Samael312/ESPKI/Hardware/Documentación/Vistas/Vista Lateral Derecha Modelo 3D.png

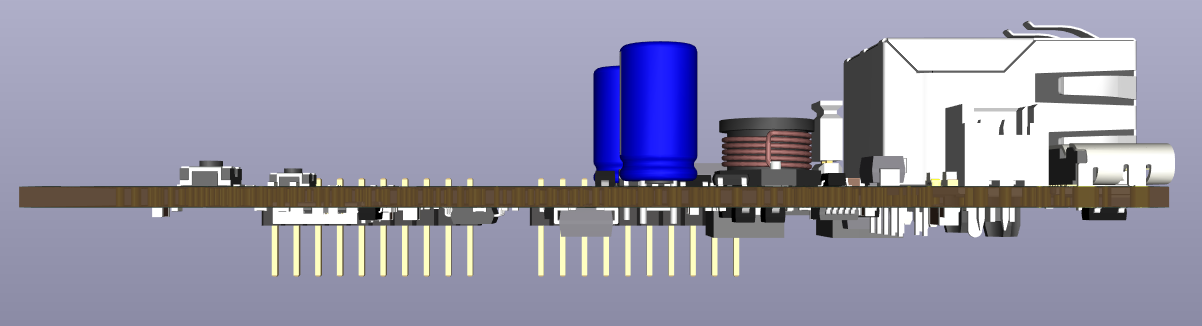
Hardware/Documentación/Vistas/Vista Lateral Derecha Modelo 3D.png
