Samael312/ESPKI/Hardware/Documentación/Vistas/Isometrica invertida.png

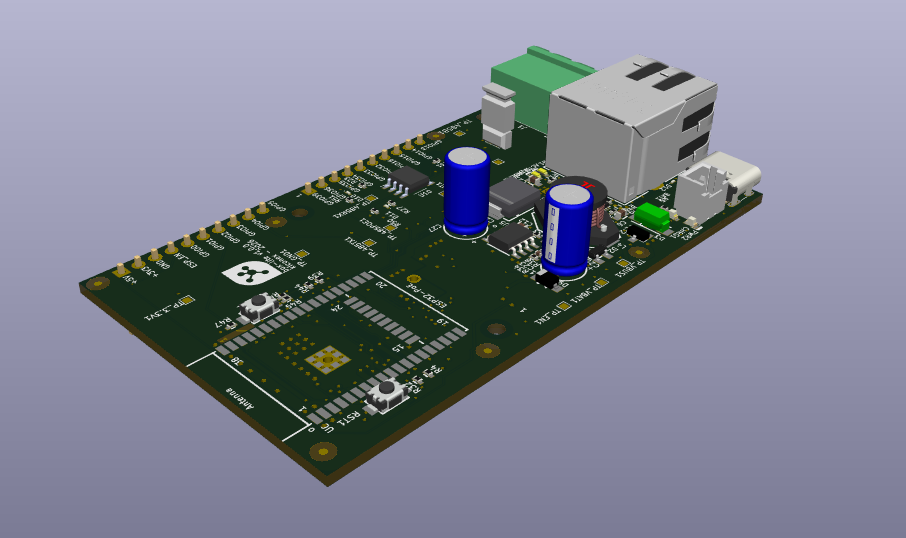
Hardware/Documentación/Vistas/Isometrica invertida.png
