Samael312/ESPKI/Hardware/Documentación/PERTE CHIP-kiconex box lite v1.00.docx

# Fase 1 — MPV y Prototipado

Objetivo: Evaluación de requisitos mínimos y selección de elementos para prototipado y pruebas básicas. Demostrar integración mínima con la arquitectura MQTT actual e inyectar métricas virtuales para cerrar la decisión de hardware.

### 1. Contrato de integración mínimo

Definir el contrato mínimo de intercambio con backend para permitir:

- presencia del dispositivo en plataforma
- publicación de telemetría básica
- señalización de estado de conexión
- y recepción básica de configuración

Debe quedar cerrado:

- estructura de topics
- formato JSON
- identificador único de dispositivo
- frecuencia de publicación
- QoS/retained cuando aplique
- Criterios de validación por mensaje

Al menos deberían existir estos mensajes:

- connection/status
- telemetry
- link-status (opcional en MVP)
- ack/error de configuración

Entregable:
Requerimientos Kiconex Box Lite – v0.0.1

Go/No-Go: documentación de implementación mínima

Recomendación: fijar ya valores por defecto para funcionamiento básico, por ejemplo:

1. telemetría cada 60 s
2. connection/status con LWT
3. payloads JSON estrictos con campos obligatorios definidos

### 2. Firmware base

Seleccionar la base técnica del MVP:

- MCU objetivo
- framework de desarrollo
- RTOS / arquitectura de tareas
- estrategia de logs y diagnóstico

Debe incluir:

- arranque robusto
- logs por UART
- contador de reinicios
- Watchdog
- separación mínima de tareas (net, mqtt, telemetry, supervision)

Entregable: firmware que arranca y permanece estable durante 24 h.

Go/No-Go: sin bloqueos, sin reinicios inesperados y con arranque reproducible.

Punto crítico: en esta fase conviene decidir también la estrategia de build:

- ESP-IDF si se prioriza control fino y estabilidad
- PlatformIO si priorizáis velocidad de iteración

3. Conexión al broker y publicación

Implementar el cliente MQTT con:

- conexión
- reconexión automática
- LWT online/offline
- publicación periódica
- y patrón de datos dummy determinista para depuración

Debe validarse en dos escenarios:

- sin TLS
- con TLS/certificados

Entregable: dispositivo visible en plataforma y datos visibles en una vista simple.

Go/No-Go:

- conexión estable con TLS
- reconexión automática funcional
- publicación continua sin intervención manual
- presencia correcta en vista simple/extendida

Recomendación: usar datos dummy reproducibles (contador, onda simple, secuencia fija) para que backend y firmware puedan depurar exactamente el mismo comportamiento.

### 4.1. Suscripción a topics de configuración

Añadir suscripción a:

- device
- controls
- controls-entities

Implementar:

- recepción
- parseo
- validación estructural

En esta fase el objetivo no es “usar toda la config”, sino comprobar que el dispositivo:

- la recibe
- la entiende
- y no colapsa en memoria

Entregable: dispositivo que recibe configuración correctamente o informe justificando límite de memoria.

Go/No-Go:

- tasa de parseo correcta
- validación consistente
- consumo de memoria dentro de umbrales aceptables

### 4.2. Medición para decisión de hardware

Realizar mediciones objetivas para cerrar el hardware:

- uso medio y pico de CPU
- uso medio y pico de RAM
- flash ocupada
- consumo eléctrico
- latencia de publish
- tiempo de reconexión
- comportamiento ante red degradada

Ensayos mínimos:

- caída de broker
- pérdida de red
- reconexión repetida
- arranque en condiciones no ideales
- test de estabilidad 24–72 h

Entregable: informe de dimensionamiento con recomendación de MCU y memoria

Go/No-Go: recomendación de hardware cerrada con evidencia medible

Umbrales sugeridos:

- RAM pico < 70%
- tiempo de reconexión < 15 s
- uptime de 72 h sin reset inesperado
- margen de flash suficiente para crecimiento futuro

### 5. Finalización de Fase 1

Con la evidencia de la fase, cerrar:

- decisión de hardware
- interfaces físicas mínimas
- y requisitos suficientes para iniciar PCB/mecánico en paralelo.

Entregable: Requerimiento Hardware Fase 1

Salida de fase: base suficientemente estable para iniciar diseño electrónico-industrial sin rehacer la arquitectura

## Criterio de éxito de Fase 1

La Fase 1 se considera superada si:

- el dispositivo aparece en plataforma como conectado
- publica telemetría cada 60 s durante 24–72 h
- soporta pérdida de red y se reconecta solo
- y queda validado el dimensionamiento de hardware para arrancar el diseño físico.

# Fase 2 — Prototipo con funcionamiento completo

Objetivo: cubrir operación real de campo con configuración remota, control, protocolo industrial y robustez de explotación.

### 1. Modelo de datos y configuración remota

Implementar el modelo completo:

- device
- controls
- entities

Con:

- límites explícitos,
- validación de configuración,
- persistencia en NVS/flash,
- ack/error de aplicación.

Aquí ya no basta con recibir la config: debe aplicarse y persistir tras reinicio.

### 2. Protocolo de campo

Prioridad inicial: Modbus

Implementar:

- polling,
- GET / REPORT / SET,
- timeouts,
- retries,
- estado online/offline del control,
- publicación de estados y valores compatibles con backend.

### 3. Store-and-forward

Definir política de resiliencia de datos:

- cola persistente en flash o cola en RAM
- límites máximos
- política de descarte
- TTL
- prioridad
- replay ordenado al reconectar.

### 4. Comandos operativos

Implementar como mínimo:

- provision
- halt/restart
- device-info

Además:

- diagnóstico remoto,
- métricas de salud,
- y visibilidad de estado interno.

### 5. Seguridad y endurecimiento

- Añadir:
- TLS/certificados,
- límites anti-flood,
- watchdog integral,
- brown-out handling,
- tests prolongados,
- y validación ante reconexiones masivas.
- Ensayos recomendados:
- soak test de 72 h+
- ciclos de reconexión repetidos
- microcortes de alimentación
- degradación de señal/red

### 6. Piloto real

- Desplegar un piloto controlado:
- 2 a 5 equipos
- entorno real
- comparativa funcional frente a quiiotd
- identificación de gaps
- cierre de backlog previo a preproducción

## Criterio de éxito de Fase 2

- La Fase 2 se considera superada si:
- la integración es completa en el backend actual, sin flujos especiales,
- el control remoto y la adquisición de campo son estables,
- el equipo resiste cortes de red y energía,
- y la base queda lista para iterar hacia producto.
