Samael312/ESPKI/Hardware/Documentación/Carcasa/Vistas/Base.png

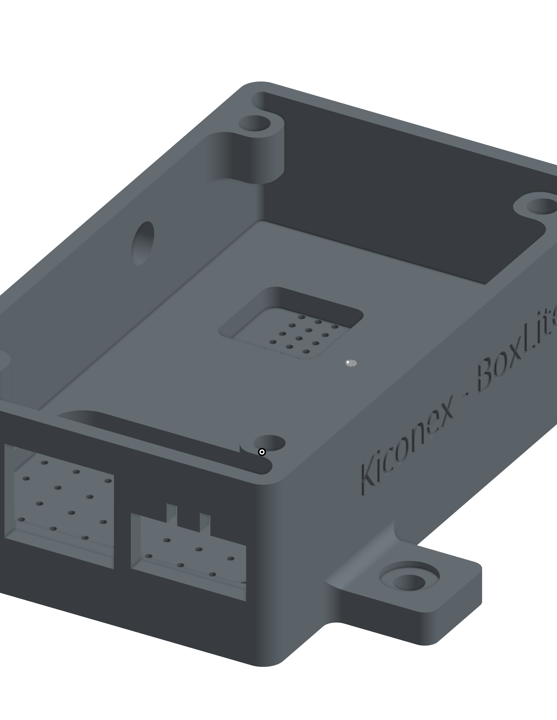
Hardware/Documentación/Carcasa/Vistas/Base.png
