Samael312/ESPKI/Hardware/Documentación/Carcasa/Vistas/Cubierta.png

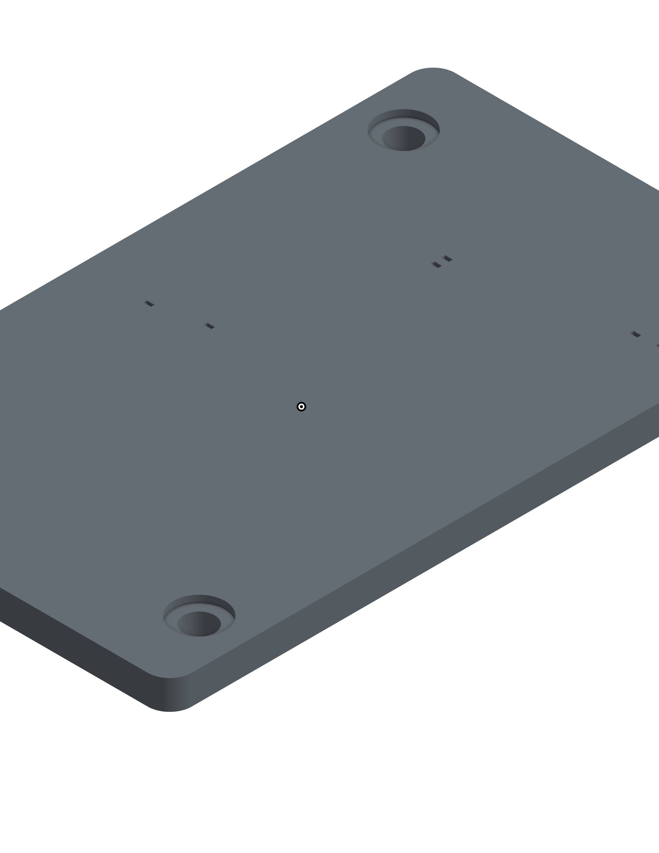
Hardware/Documentación/Carcasa/Vistas/Cubierta.png
