Samael312/ESPKI/Hardware/Documentación/Vistas/Vista Frontal Modelo 3D.png

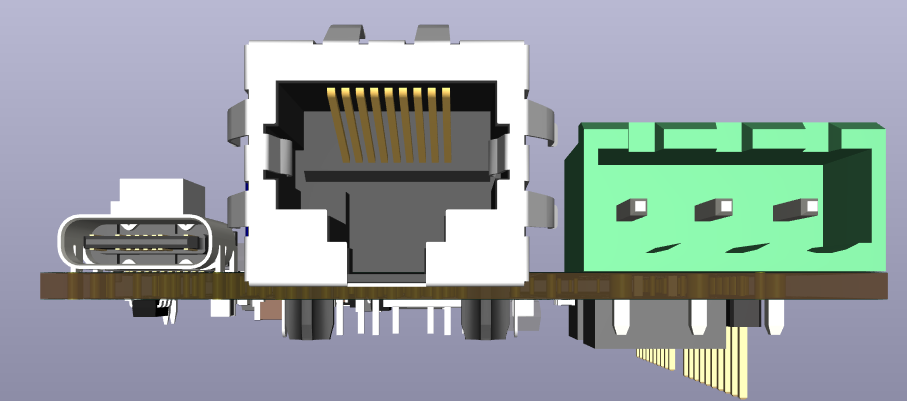
Hardware/Documentación/Vistas/Vista Frontal Modelo 3D.png
