Samael312/ESPKI/Hardware/Documentación/Vistas/Vista Lateral Izquierda Modelo 3D.png

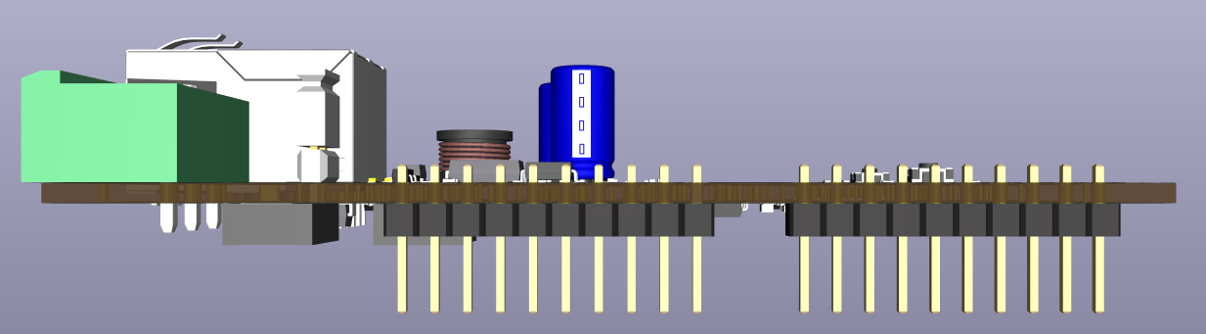
Hardware/Documentación/Vistas/Vista Lateral Izquierda Modelo 3D.png
