Samael312/ESPKI/Hardware/Documentación/Vistas/Vista Trasera Modelo 3D.png

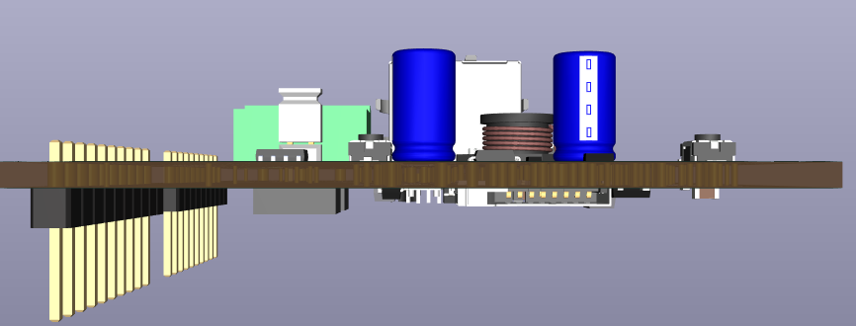
Hardware/Documentación/Vistas/Vista Trasera Modelo 3D.png
