Samael312/ESPKI/Hardware/Carcasa.FCStd

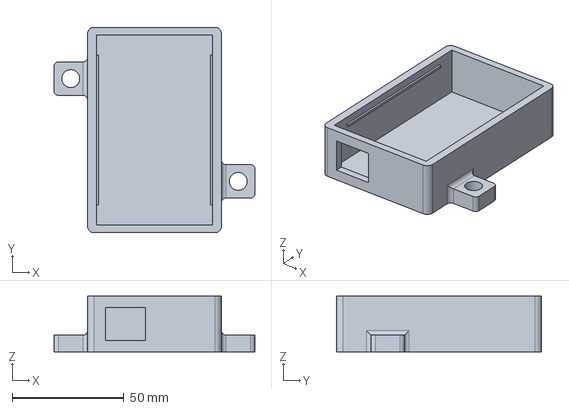
[picture p15: CAD file, 2026-04-23]
Hardware/Carcasa.FCStd
90.0 x 92.0 x 25.0 mm
