Samael312/ESPKI/Hardware/Documentación/Carcasa/Base.step

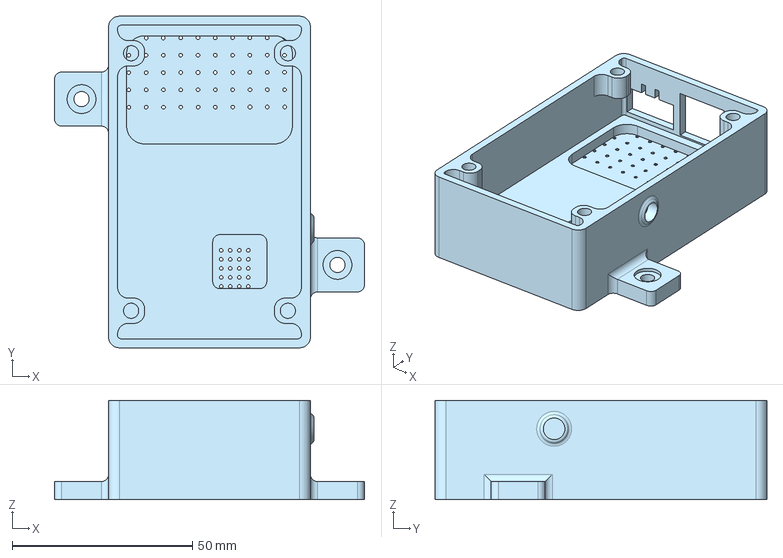
[picture p16: CAD file, 2026-04-24]
Hardware/Documentación/Carcasa/Base.step
86.0 x 92.0 x 27.5 mm
