Samael312/ESPKI/Hardware/Box-Lite.FCStd

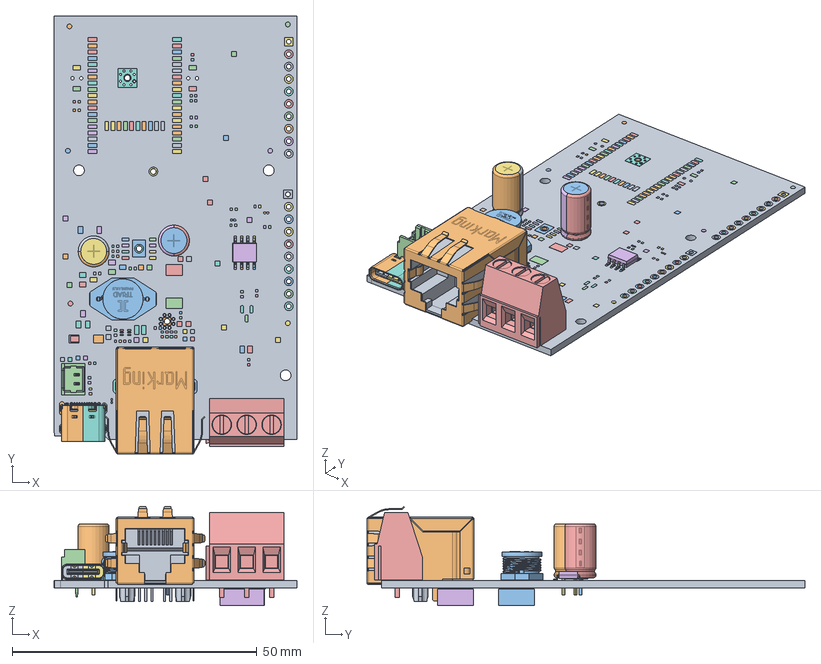
[picture p17: CAD file, 2026-04-23]
Hardware/Box-Lite.FCStd
49.6 x 89.4 x 20.2 mm
insulator
shielding
Cap_PTH_6_3x11x2_5mm
Cap_PTH_6_3x11x2_5mm001
Cap_PTH_6_3x11x2_5mm002
Cap_PTH_6_3x11x2_5mm003
Cap_PTH_6_3x11x2_5mm005
Cap_PTH_6_3x11x2_5mm006
Cap_PTH_6_3x11x2_5mm007
Cap_PTH_6_3x11x2_5mm008
L_AX97-103R3
Molex_PicoBlade_530470210
TerminalBlock_Phoenix_MKDS-1,5-3-5.08_1x03_P5.08mm_Horizontal
MAX13487E
MAX13487E001
MAX13487E002
MAX13487E003
MAX13487E004
MAX13487E005
MAX13487E006
MAX13487E007
MAX13487E008
USB_C_Receptacle_GCT_USB4105-xx-A_16P_TopMnt_Horizontal
USB_C_Receptacle_GCT_USB4105-xx-A_16P_TopMnt_Horizontal001
USB_C_Receptacle_GCT_USB4105-xx-A_16P_TopMnt_Horizontal002
USB_C_Receptacle_GCT_USB4105-xx-A_16P_TopMnt_Horizontal003
USB_C_Receptacle_GCT_USB4105-xx-A_16P_TopMnt_Horizontal004
USB_C_Receptacle_GCT_USB4105-xx-A_16P_TopMnt_Horizontal005
USB_C_Receptacle_GCT_USB4105-xx-A_16P_TopMnt_Horizontal006
USB_C_Receptacle_GCT_USB4105-xx-A_16P_TopMnt_Horizontal007
USB_C_Receptacle_GCT_USB4105-xx-A_16P_TopMnt_Horizontal008
USB_C_Receptacle_GCT_USB4105-xx-A_16P_TopMnt_Horizontal009
USB_C_Receptacle_GCT_USB4105-xx-A_16P_TopMnt_Horizontal010
USB_C_Receptacle_GCT_USB4105-xx-A_16P_TopMnt_Horizontal011
USB_C_Receptacle_GCT_USB4105-xx-A_16P_TopMnt_Horizontal012
USB_C_Receptacle_GCT_USB4105-xx-A_16P_TopMnt_Horizontal013
USB_C_Receptacle_GCT_USB4105-xx-A_16P_TopMnt_Horizontal014
USB_C_Receptacle_GCT_USB4105-xx-A_16P_TopMnt_Horizontal015
USB_C_Receptacle_GCT_USB4105-xx-A_16P_TopMnt_Horizontal016
USB_C_Receptacle_GCT_USB4105-xx-A_16P_TopMnt_Horizontal017
USB_C_Receptacle_GCT_USB4105-xx-A_16P_TopMnt_Horizontal018
USB_C_Receptacle_GCT_USB4105-xx-A_16P_TopMnt_Horizontal019
USB_C_Receptacle_GCT_USB4105-xx-A_16P_TopMnt_Horizontal020
USB_C_Receptacle_GCT_USB4105-xx-A_16P_TopMnt_Horizontal021
USB_C_Receptacle_GCT_USB4105-xx-A_16P_TopMnt_Horizontal022
USB_C_Receptacle_GCT_USB4105-xx-A_16P_TopMnt_Horizontal023
USB_C_Receptacle_GCT_USB4105-xx-A_16P_TopMnt_Horizontal024
USB_C_Receptacle_GCT_USB4105-xx-A_16P_TopMnt_Horizontal025
USB_C_Receptacle_GCT_USB4105-xx-A_16P_TopMnt_Horizontal026
USB_C_Receptacle_GCT_USB4105-xx-A_16P_TopMnt_Horizontal027
USB_C_Receptacle_GCT_USB4105-xx-A_16P_TopMnt_Horizontal028
USB_C_Receptacle_GCT_USB4105-xx-A_16P_TopMnt_Horizontal029
USB_C_Receptacle_GCT_USB4105-xx-A_16P_TopMnt_Horizontal030
USB_C_Receptacle_GCT_USB4105-xx-A_16P_TopMnt_Horizontal031
USB_C_Receptacle_GCT_USB4105-xx-A_16P_TopMnt_Horizontal032
USB_C_Receptacle_GCT_USB4105-xx-A_16P_TopMnt_Horizontal033
USB_C_Receptacle_GCT_USB4105-xx-A_16P_TopMnt_Horizontal034
USB_C_Receptacle_GCT_USB4105-xx-A_16P_TopMnt_Horizontal035
Pins
Pins001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
