Samael312/ESPKI/Hardware/Documentación/Carcasa/Cubierta.step

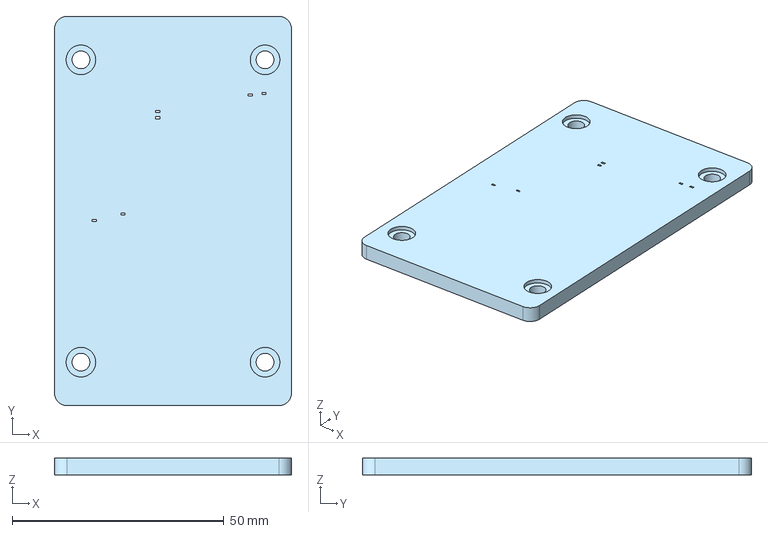
[picture p18: CAD file, 2026-04-24]
Hardware/Documentación/Carcasa/Cubierta.step
56.0 x 92.0 x 4.00 mm
