Samael312/ESPKI/Hardware/Documentación/Carcasa/Vistas/Ensamblaje.png

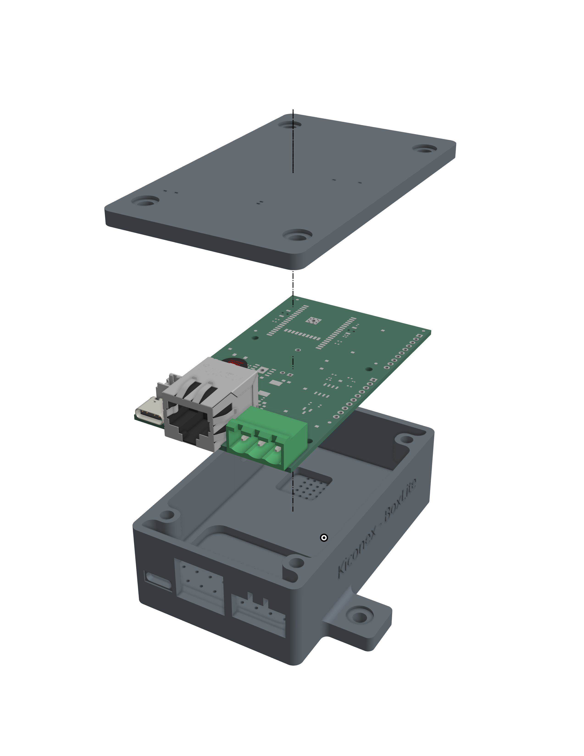
Hardware/Documentación/Carcasa/Vistas/Ensamblaje.png
