Samael312/ESPKI/Hardware/Documentación/Carcasa/Vistas/Ensamblaje_2.png

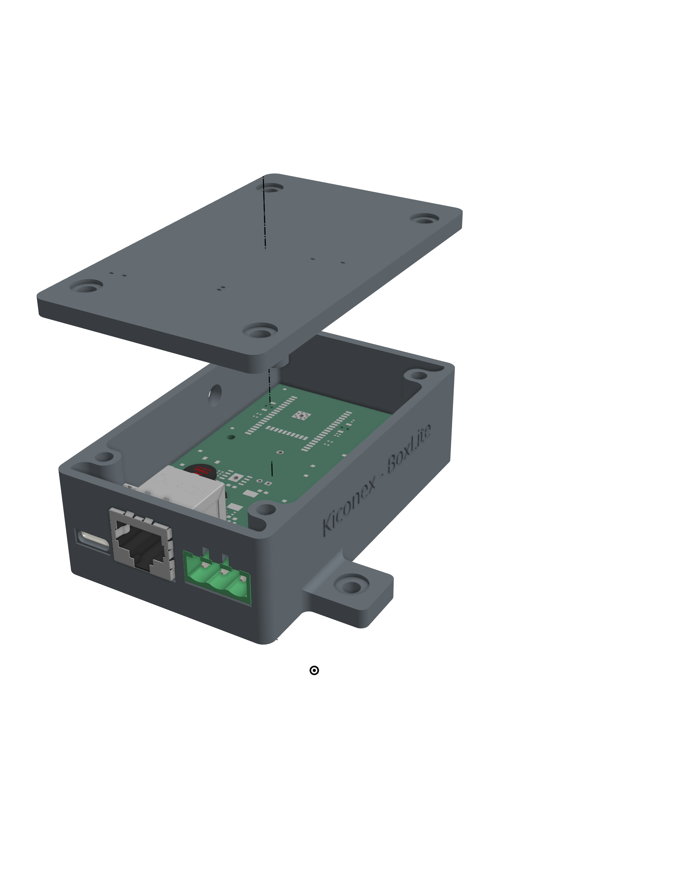
Hardware/Documentación/Carcasa/Vistas/Ensamblaje_2.png
