Samael312/ESPKI/Hardware/Documentación/KiBoxLite_H.pdf

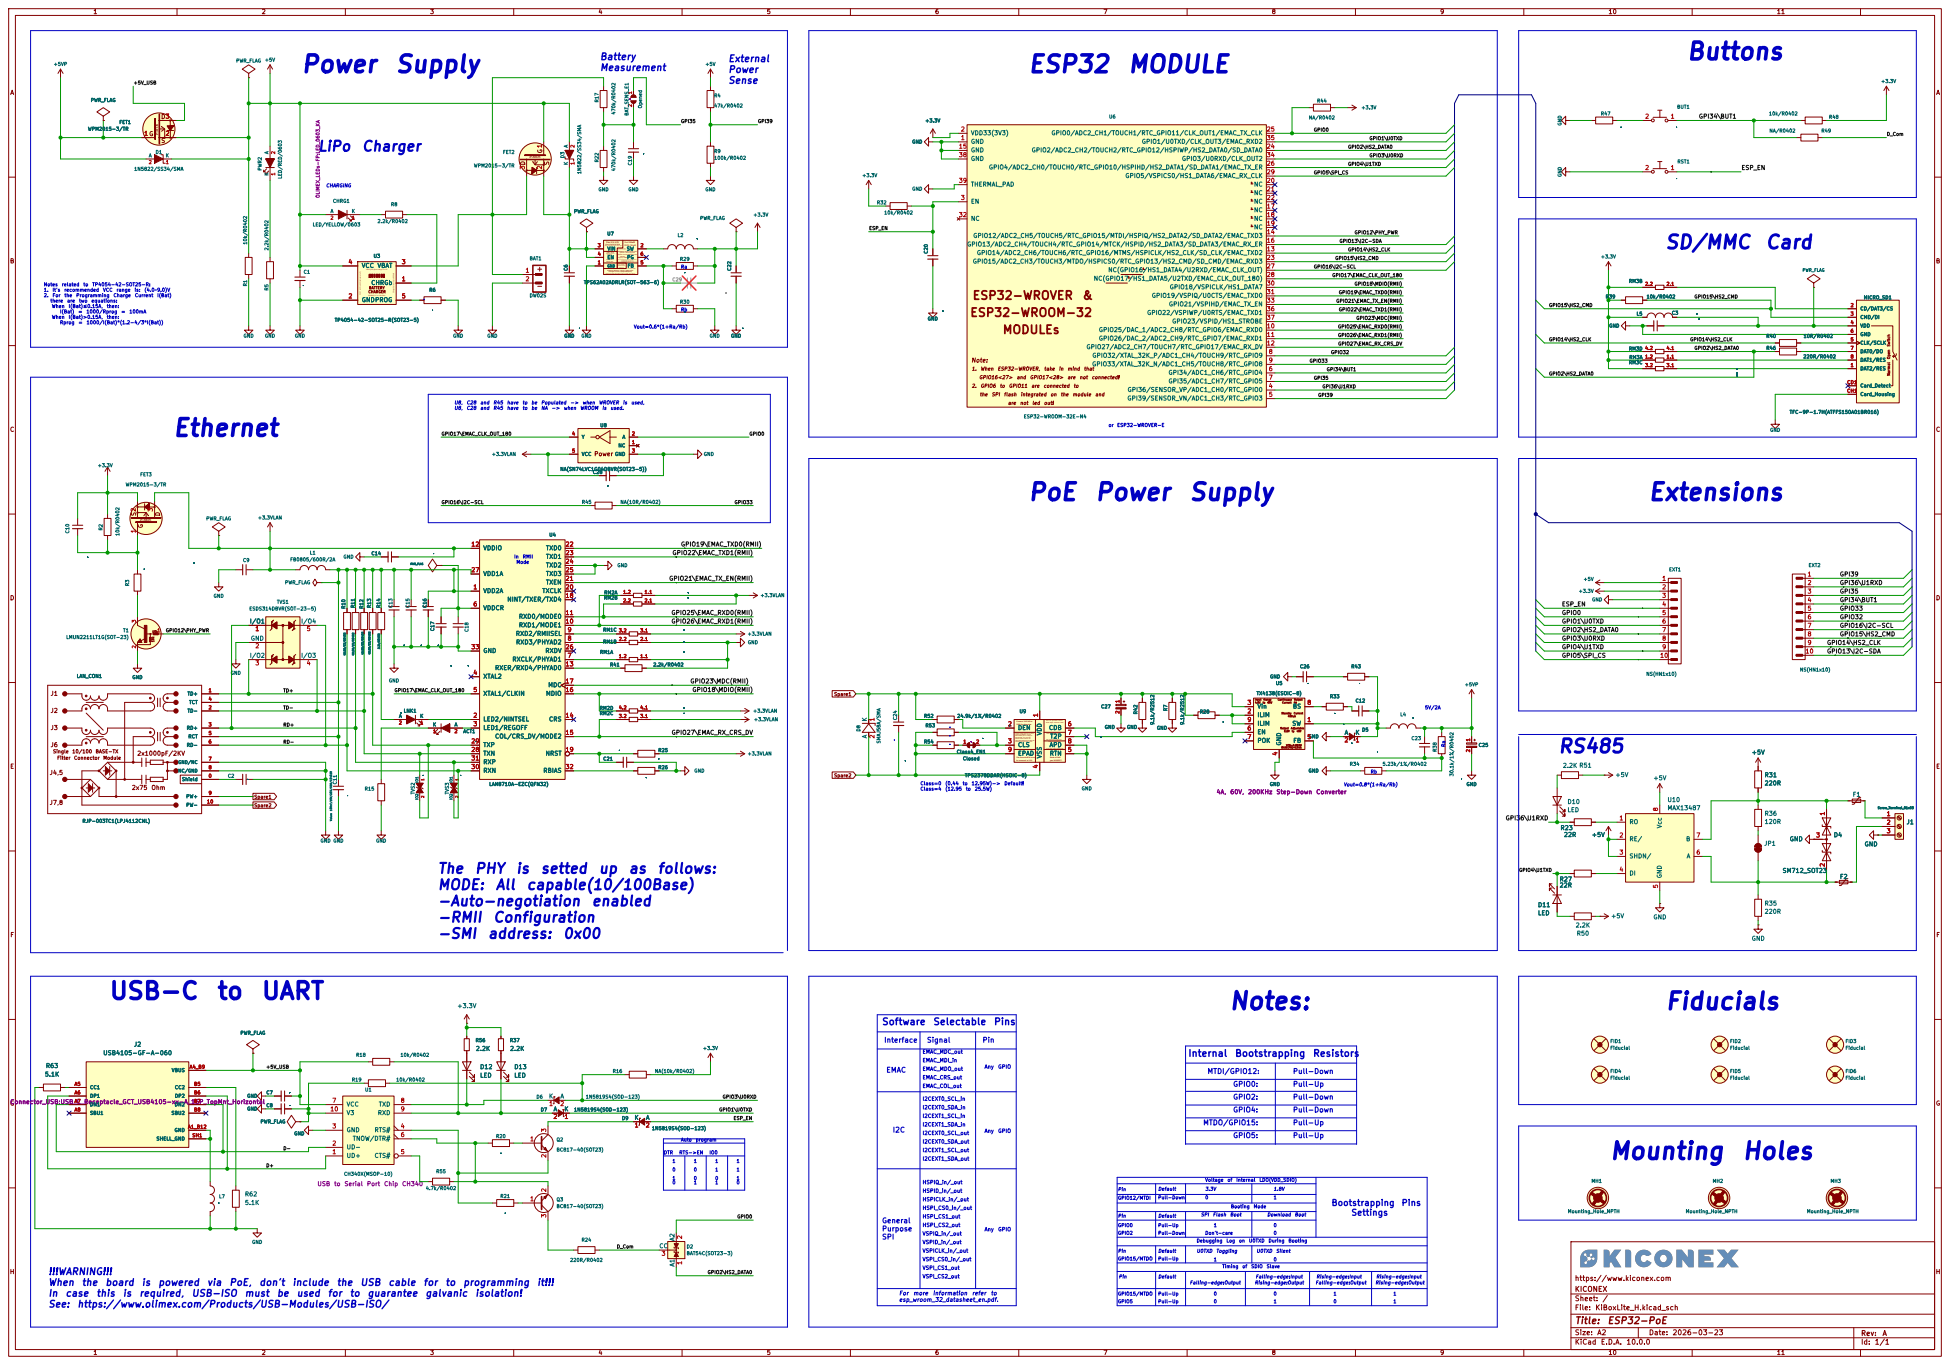
[picture p21: page 1]

LiPo Charger CHARGING A2CHRG1

SD/MMC Card +3.3V

Cin=4.7uF/6.3V/X5R
a larger value reduces input voltage ripple. Feedback Reference Voltage, V(REF)=0.6V

Pull high to turn on. Enable control. Vin=2.5-5.5V
VIN 3
TPS62A02ADRLR(SOT-563-6) GND 1

In case a lower output ripple is desired, higher output capacitance can help reduce the ripple. Lx=1.0uH

Do not float. V(ENH)=1.2V

A 0.47uH inductor can also be used with the same recommended output capacitors for the TPS62A02x. Switching Frequency 2.4MHz Maximum output current 2.0A

Cout=(10~22)uF/6.3V/X5R (Vout≥1.8V). 22uF Recommended! Cout=22uF/6.3V/X5R (1.2V≤Vout<1.8V) Cout=44uF/6.3V/X5R (0.6V≤Vout<1.2V)

FB Input Current, I(FB)=100nA(max) Rb must not be higher than 100kΩ to provide acceptable noise sensitivity. TPS62A02ADRLR

Notes related to TP4054-42-SOT25-R: 1. It's recommended VCC range is: (4.0~9.0)V 2. For the Programming Charge Current I(Bat)

1C24 A2 D8 SMAJ58A/SMA R25 10k/R0402 3.2 3.1 RM2C RA1206_(4X0603)_4B8_2.2k RM2D 4.2 4.1 RA1206_(4X0603)_4B8_2.2k C21 NA(10uF/6.3V/20%/X5R/C0603) RM1C 3.2 3.1 RA1206_(4X0603)_4B8_2.2k 1.2 1.1 RM1A RA1206_(4X0603)_4B8_2.2k Note: 2. GPIO6 to GPIO11 are connected to 1. When ESP32-WROVER, take in mind that are not led out! ESP32-WROVER &

there are two equations: When I(Bat)≤0.15A, then:

I(Bat) = 1000/Rprog = 100mA When I(Bat)>0.15A, then: Rprog = 1000/I(Bat)*(1.2-4/3*I(Bat))

Vout=0.6*(1+Ra/Rb) Rb

1 2 C25 Normal Open Switch DAT2/RES

the SPI flash integrated on the module and GPIO16<27> and GPIO17<28> are not connected!

GPIO25\EMAC_RXD0(RMII) GPIO22\EMAC_TXD1(RMII) GPIO22\EMAC_TXD1(RMII) GPIO21\EMAC_TX_EN(RMII)

1GND | 5 I/O3

TX4138(ESOIC-8) 4A, 60V, 200KHz Step-Down Converter GND

TX4138(ESOIC-8) 4A, 60V, 200KHz Step-Down Converter SW

IBIAS(FB)=10nA Standby Current 400uA Output Adjustable 0.8V to 40V

Filter Connector Module Single 10/100 BASE-TX J4,5

Class=0 (0.44 to 12.95W)-> Default! Class=4 (12.95 to 25.5W)

I2CEXT1_SDA_in The PHY is setted up as follows:
MODE: All capable(10/100Base)
-Auto-negotiation enabled
-RMII Configuration
-SMI address: 0x00

EMAC_CRS_out EMAC_MDC_out | Any GPIO Software Selectable Pins

Pull-Up

U1 CH340X(MSOP-10) USB to Serial Port Chip CH340
VCC 7

Falling-edge:Output Pull-Down Pull-Down Default GPIO12/MTDI GPIO2 GPIO0 PinPin VSPI_CS1_out

Default Pull-Up

Settings

Falling-edge:Input | Falling-edge:Output | 1 GPIO15/MTDO Rising-edge:Output

0 !!!WARNING!!!
When the board is powered via PoE, don't include the USB cable for to programming it!!!
In case this is required, USB-ISO must be used for to guarantee galvanic isolation!
See: https://www.olimex.com/Products/USB-Modules/USB-ISO/

Timing of SDIO Slave

GPIO15/MTDO | 0 0 | | | 1

Size: A2 | Rev: A
