Samael312/ESPKI/Hardware/Documentación/Carcasa/Chasis.pdf

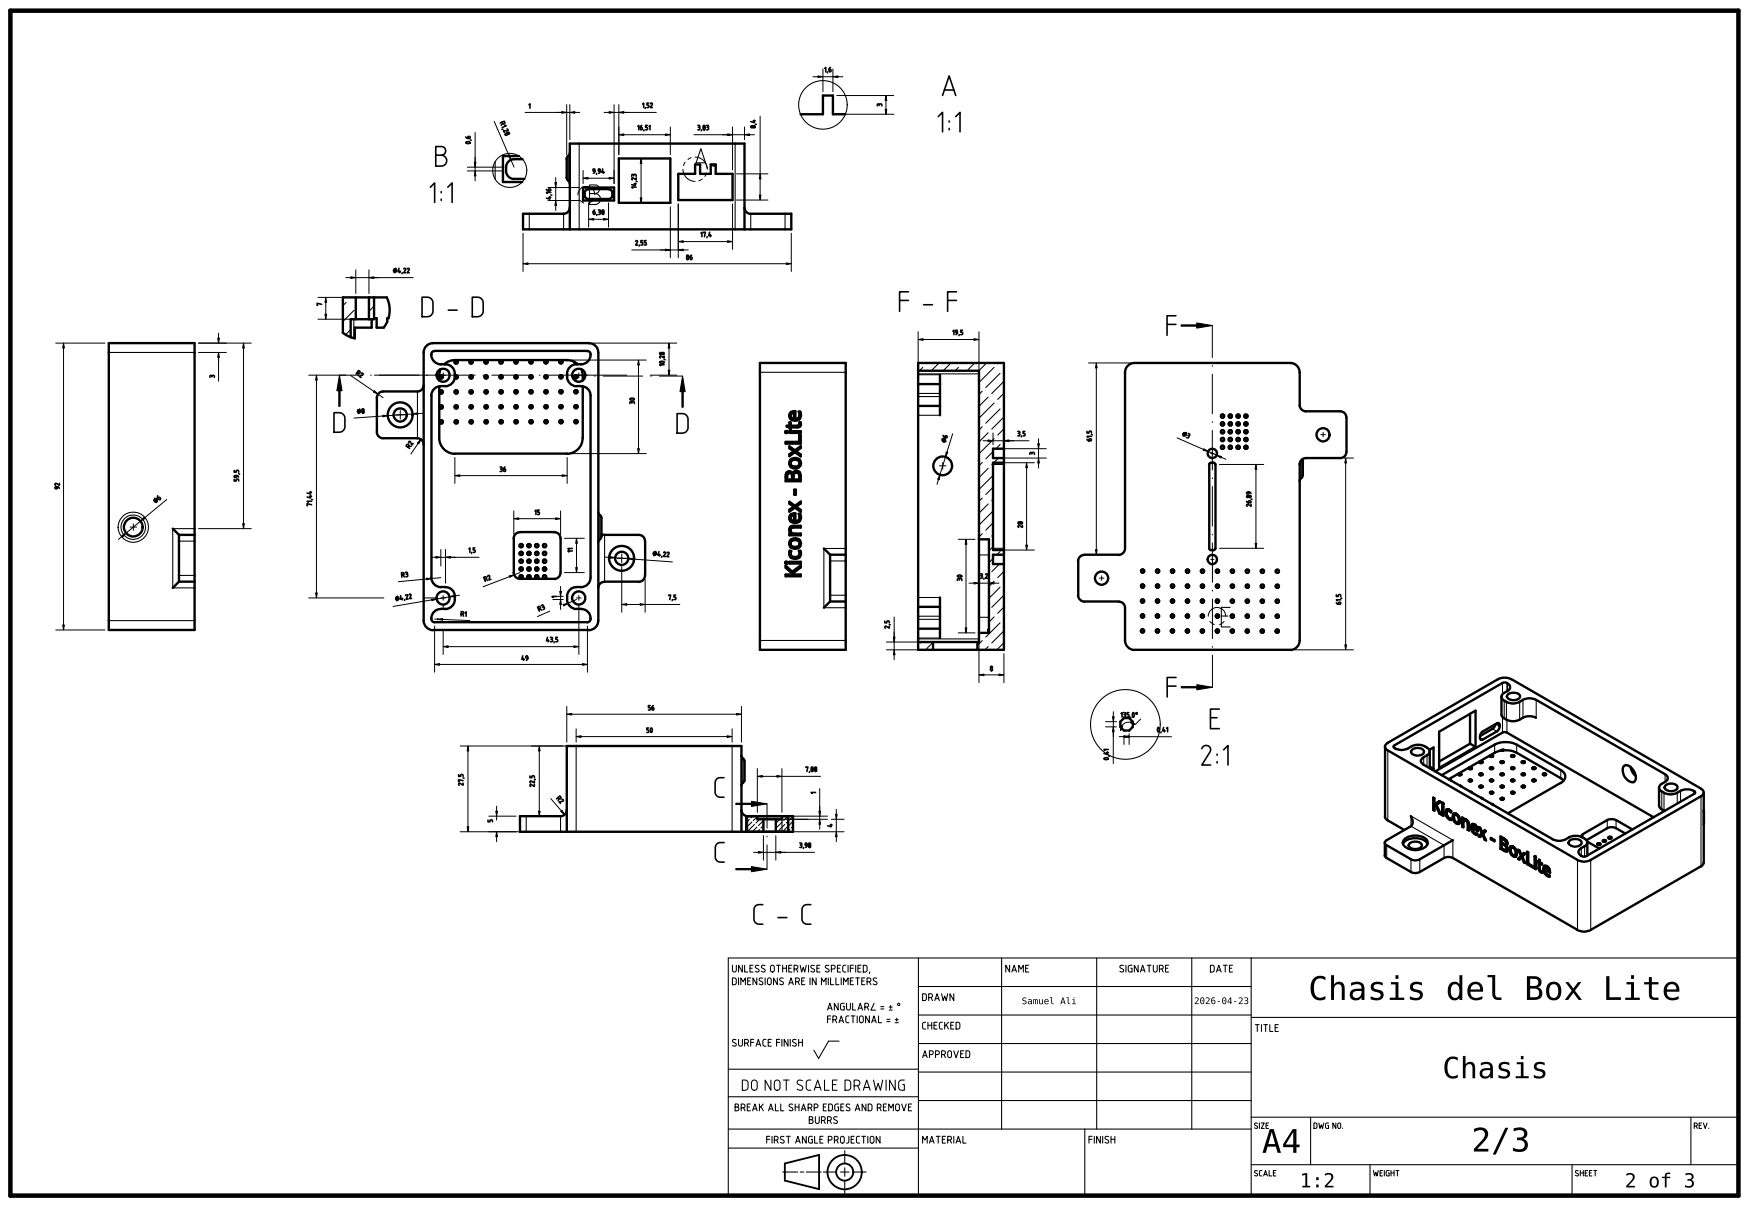
[picture p22: page 1]
