Samael312/ESPKI/Hardware/Documentación/Carcasa/Cubierta.pdf

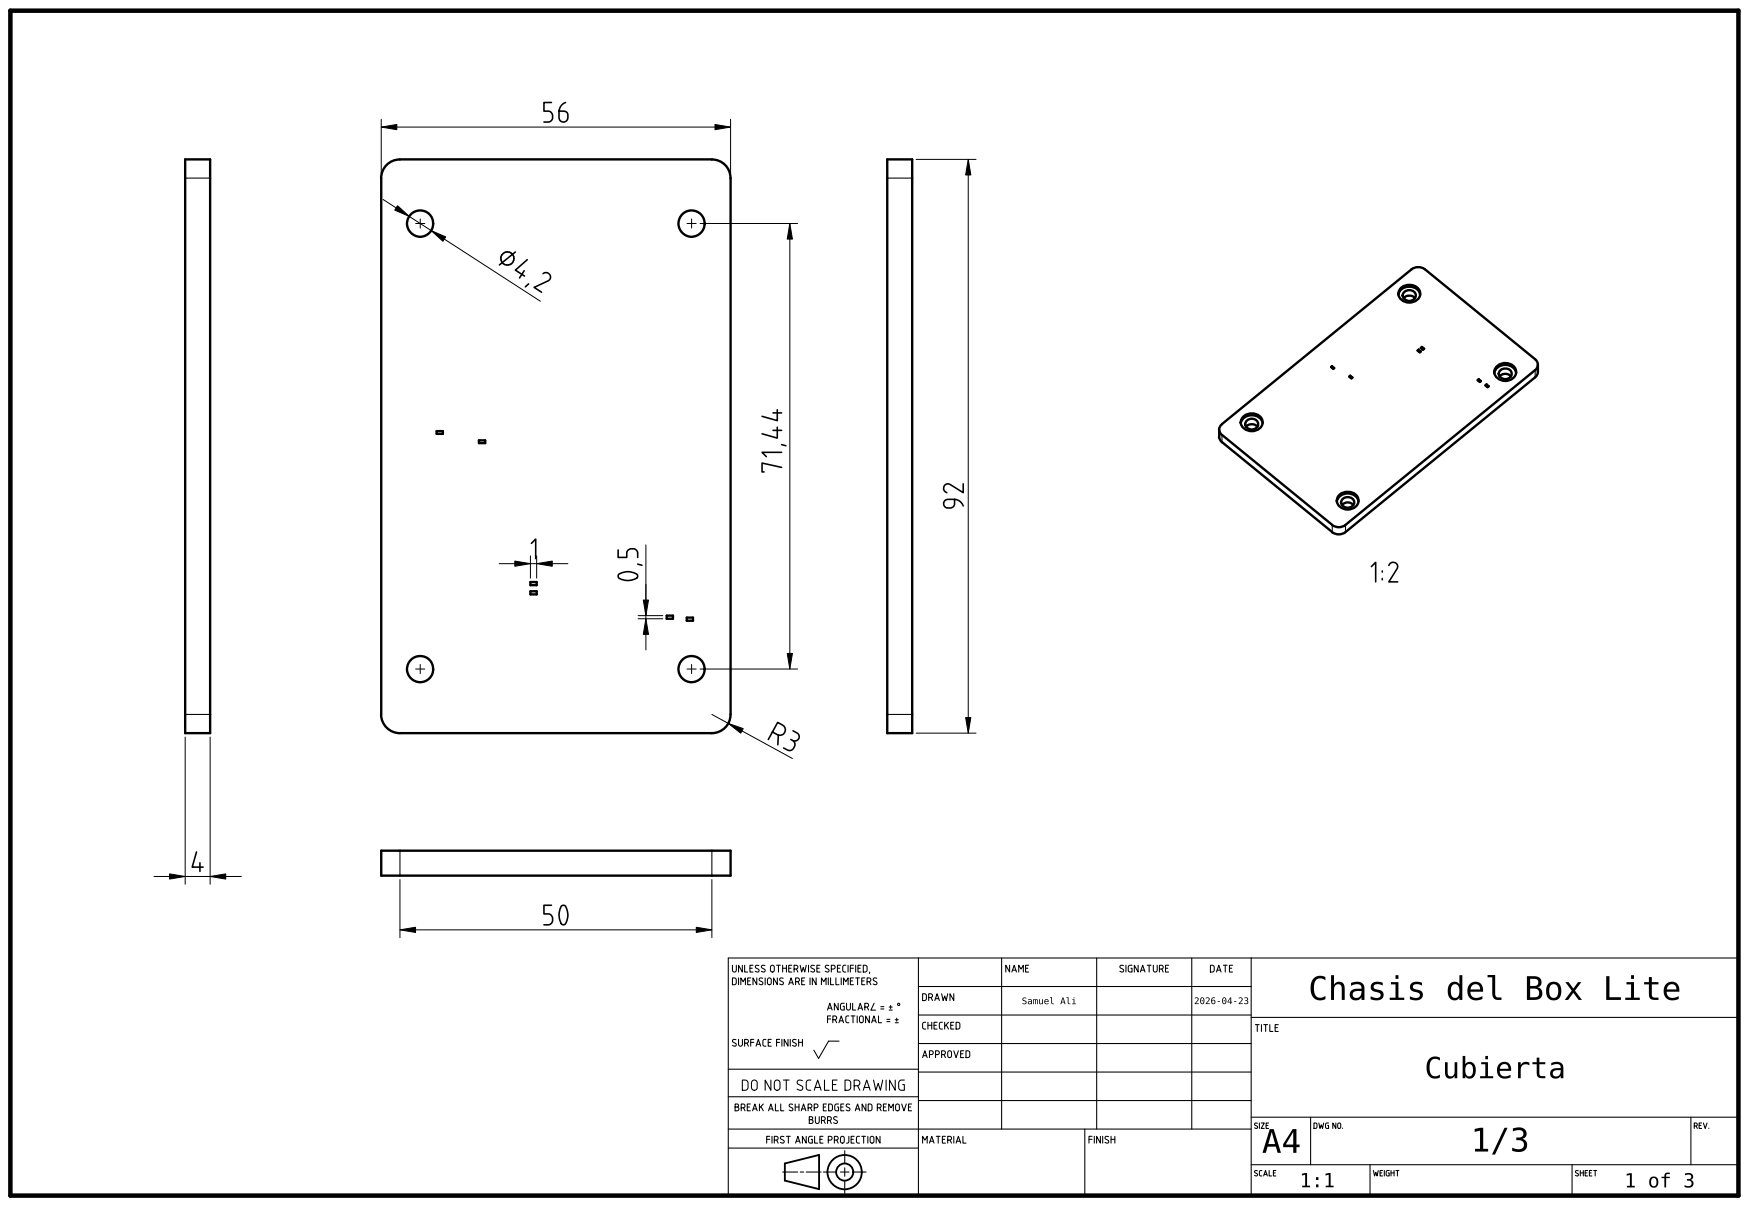
[picture p23: page 1]
