Samael312/ESPKI/Hardware/Documentación/Carcasa/Ensamblaje.pdf

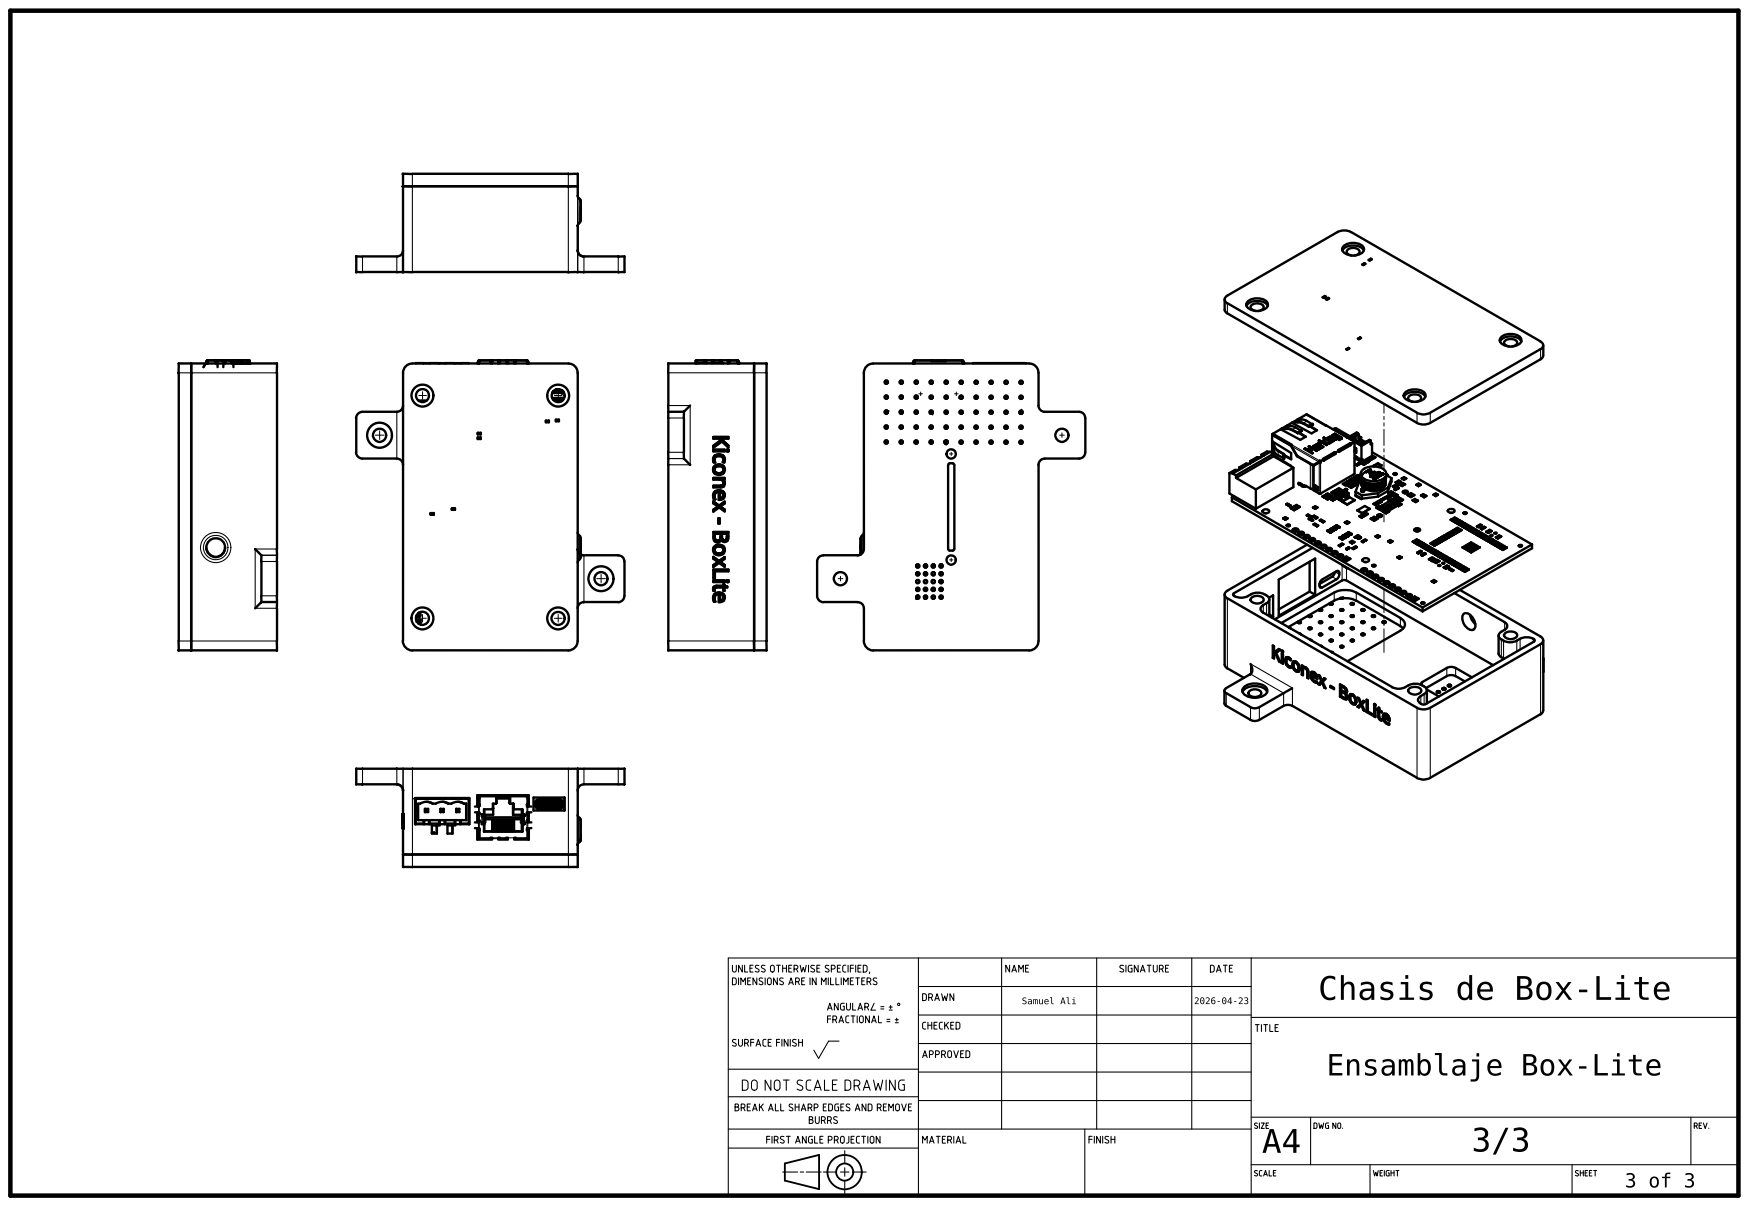
[picture p24: page 1]
