Samael312/ESPKI/Hardware/KiBoxLite_H.kicad_pcb

## KiCad design Hardware/KiBoxLite_H.kicad_pcb (2026-05-05)

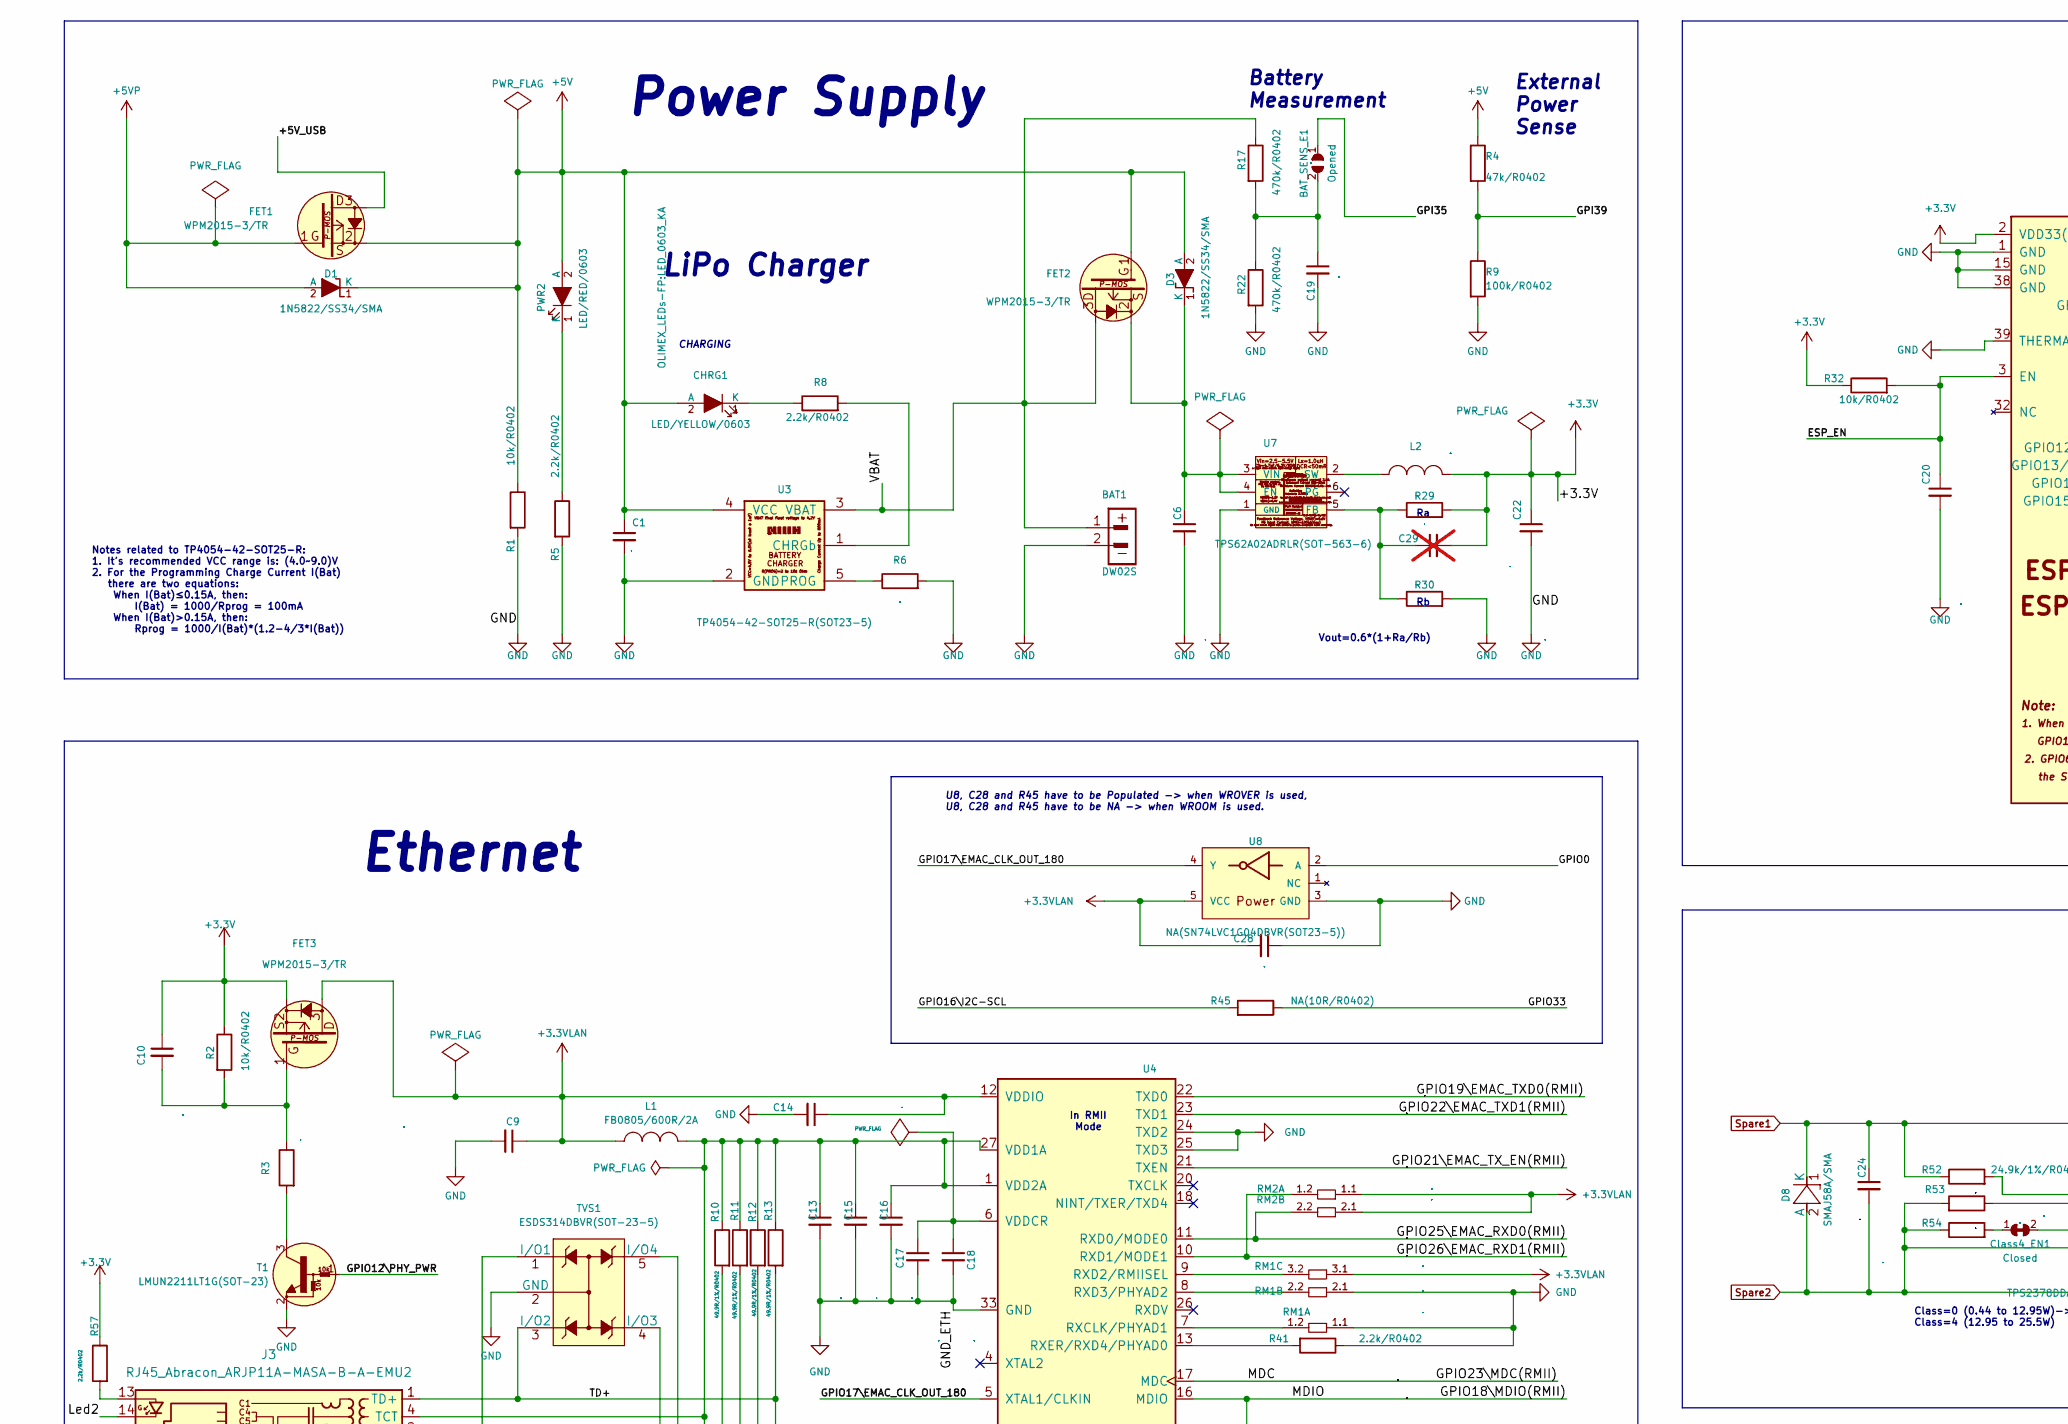
[picture p25: schematic KiBoxLite_H.kicad_sch, ESP32-PoE, part in row 1, column 1]

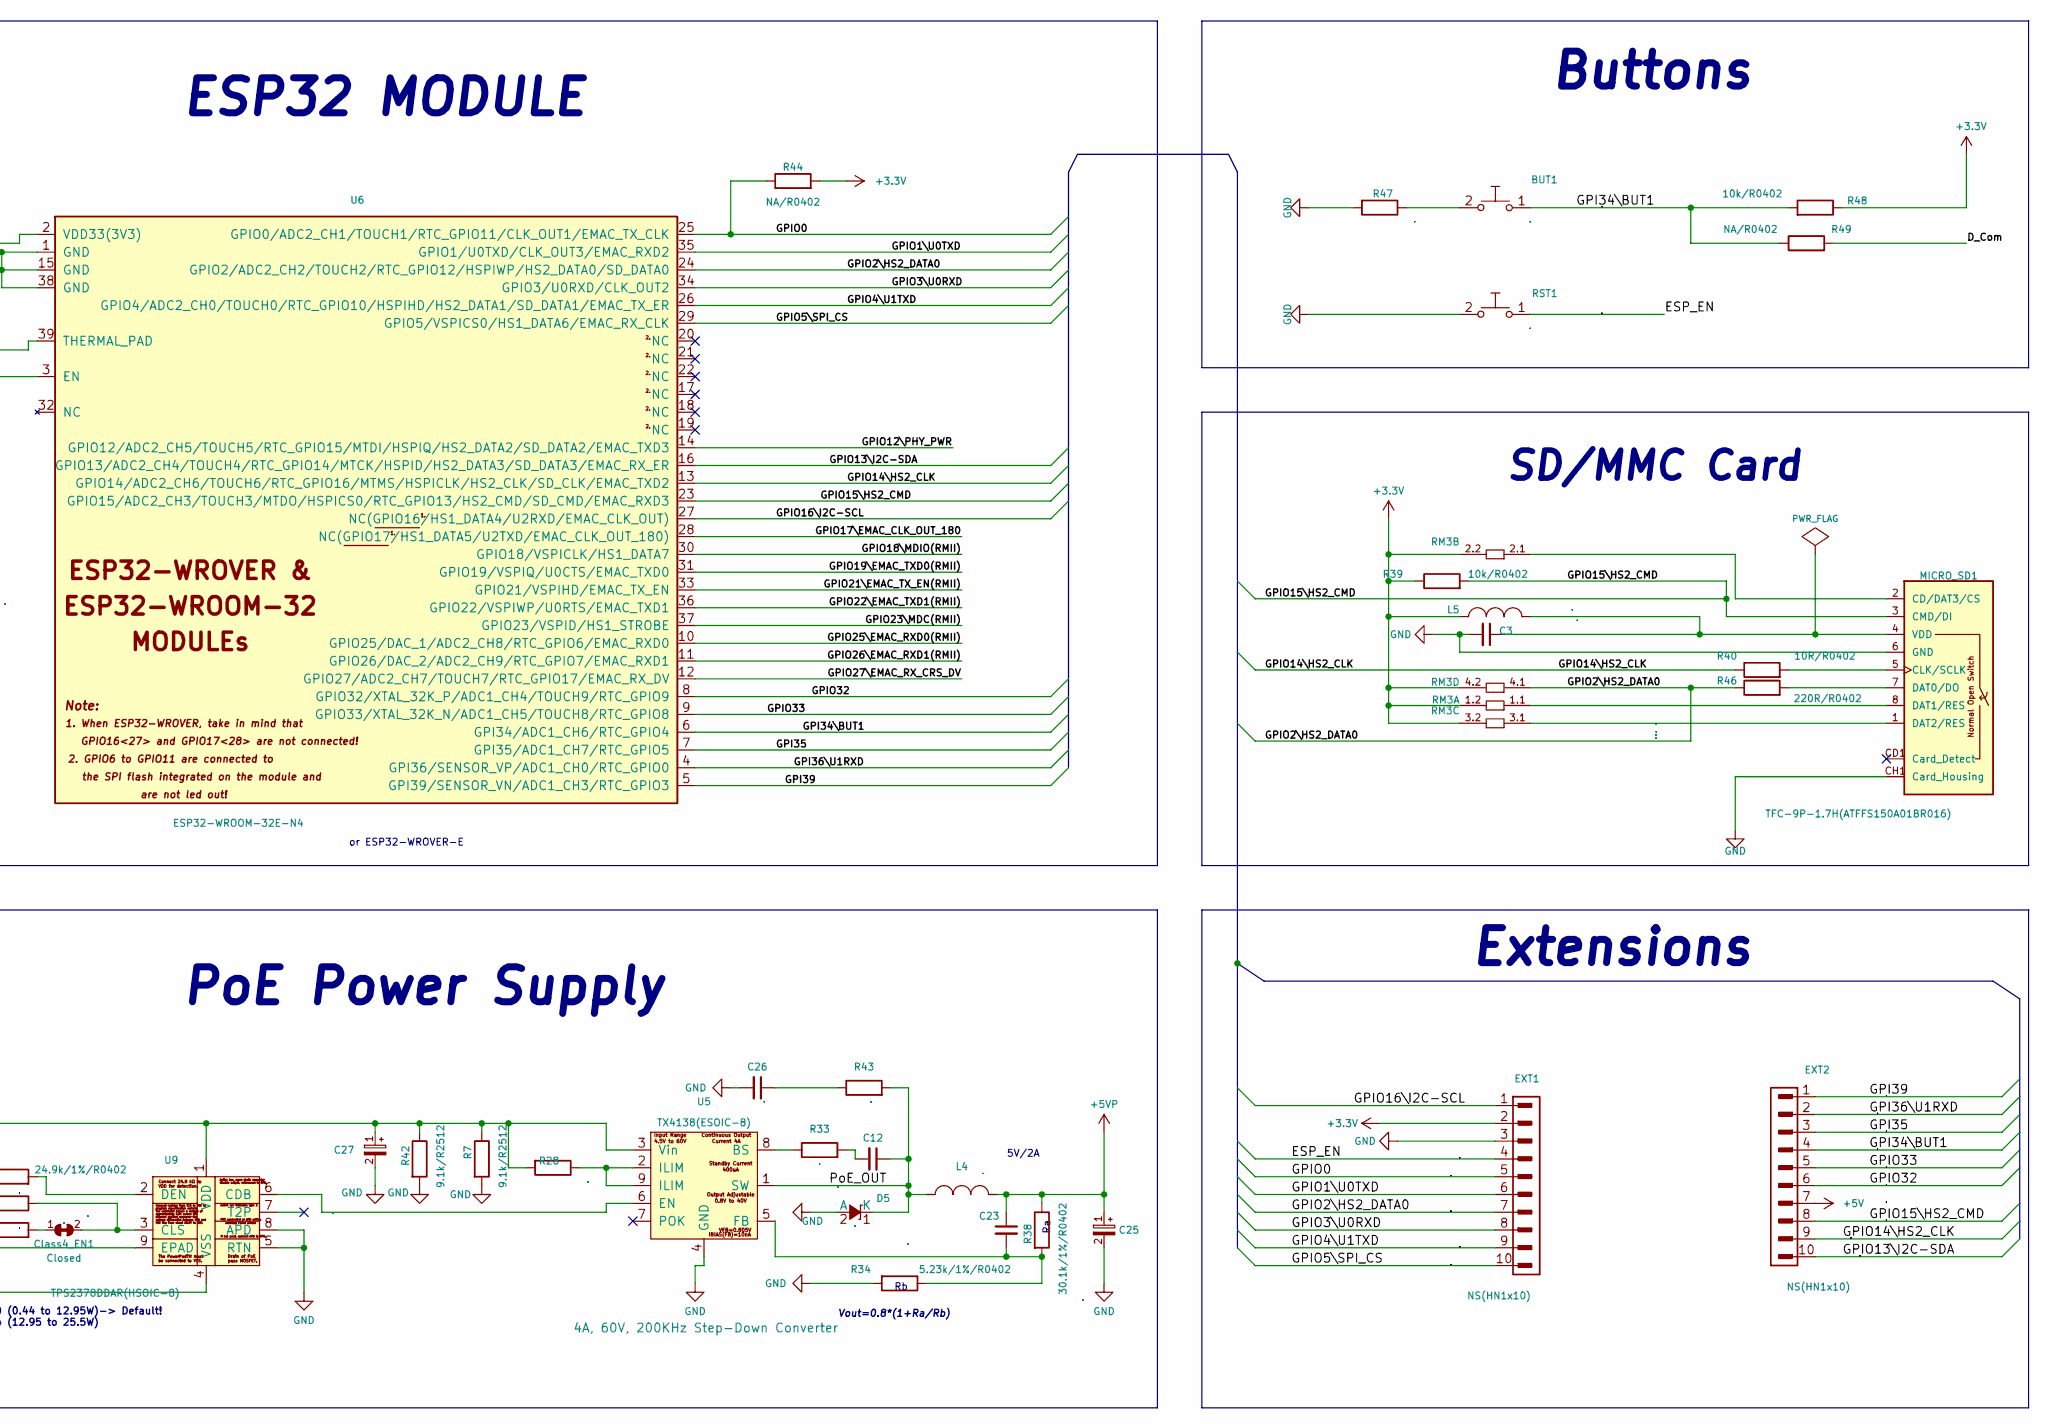
[picture p26: schematic KiBoxLite_H.kicad_sch, ESP32-PoE, part in row 1, column 2]

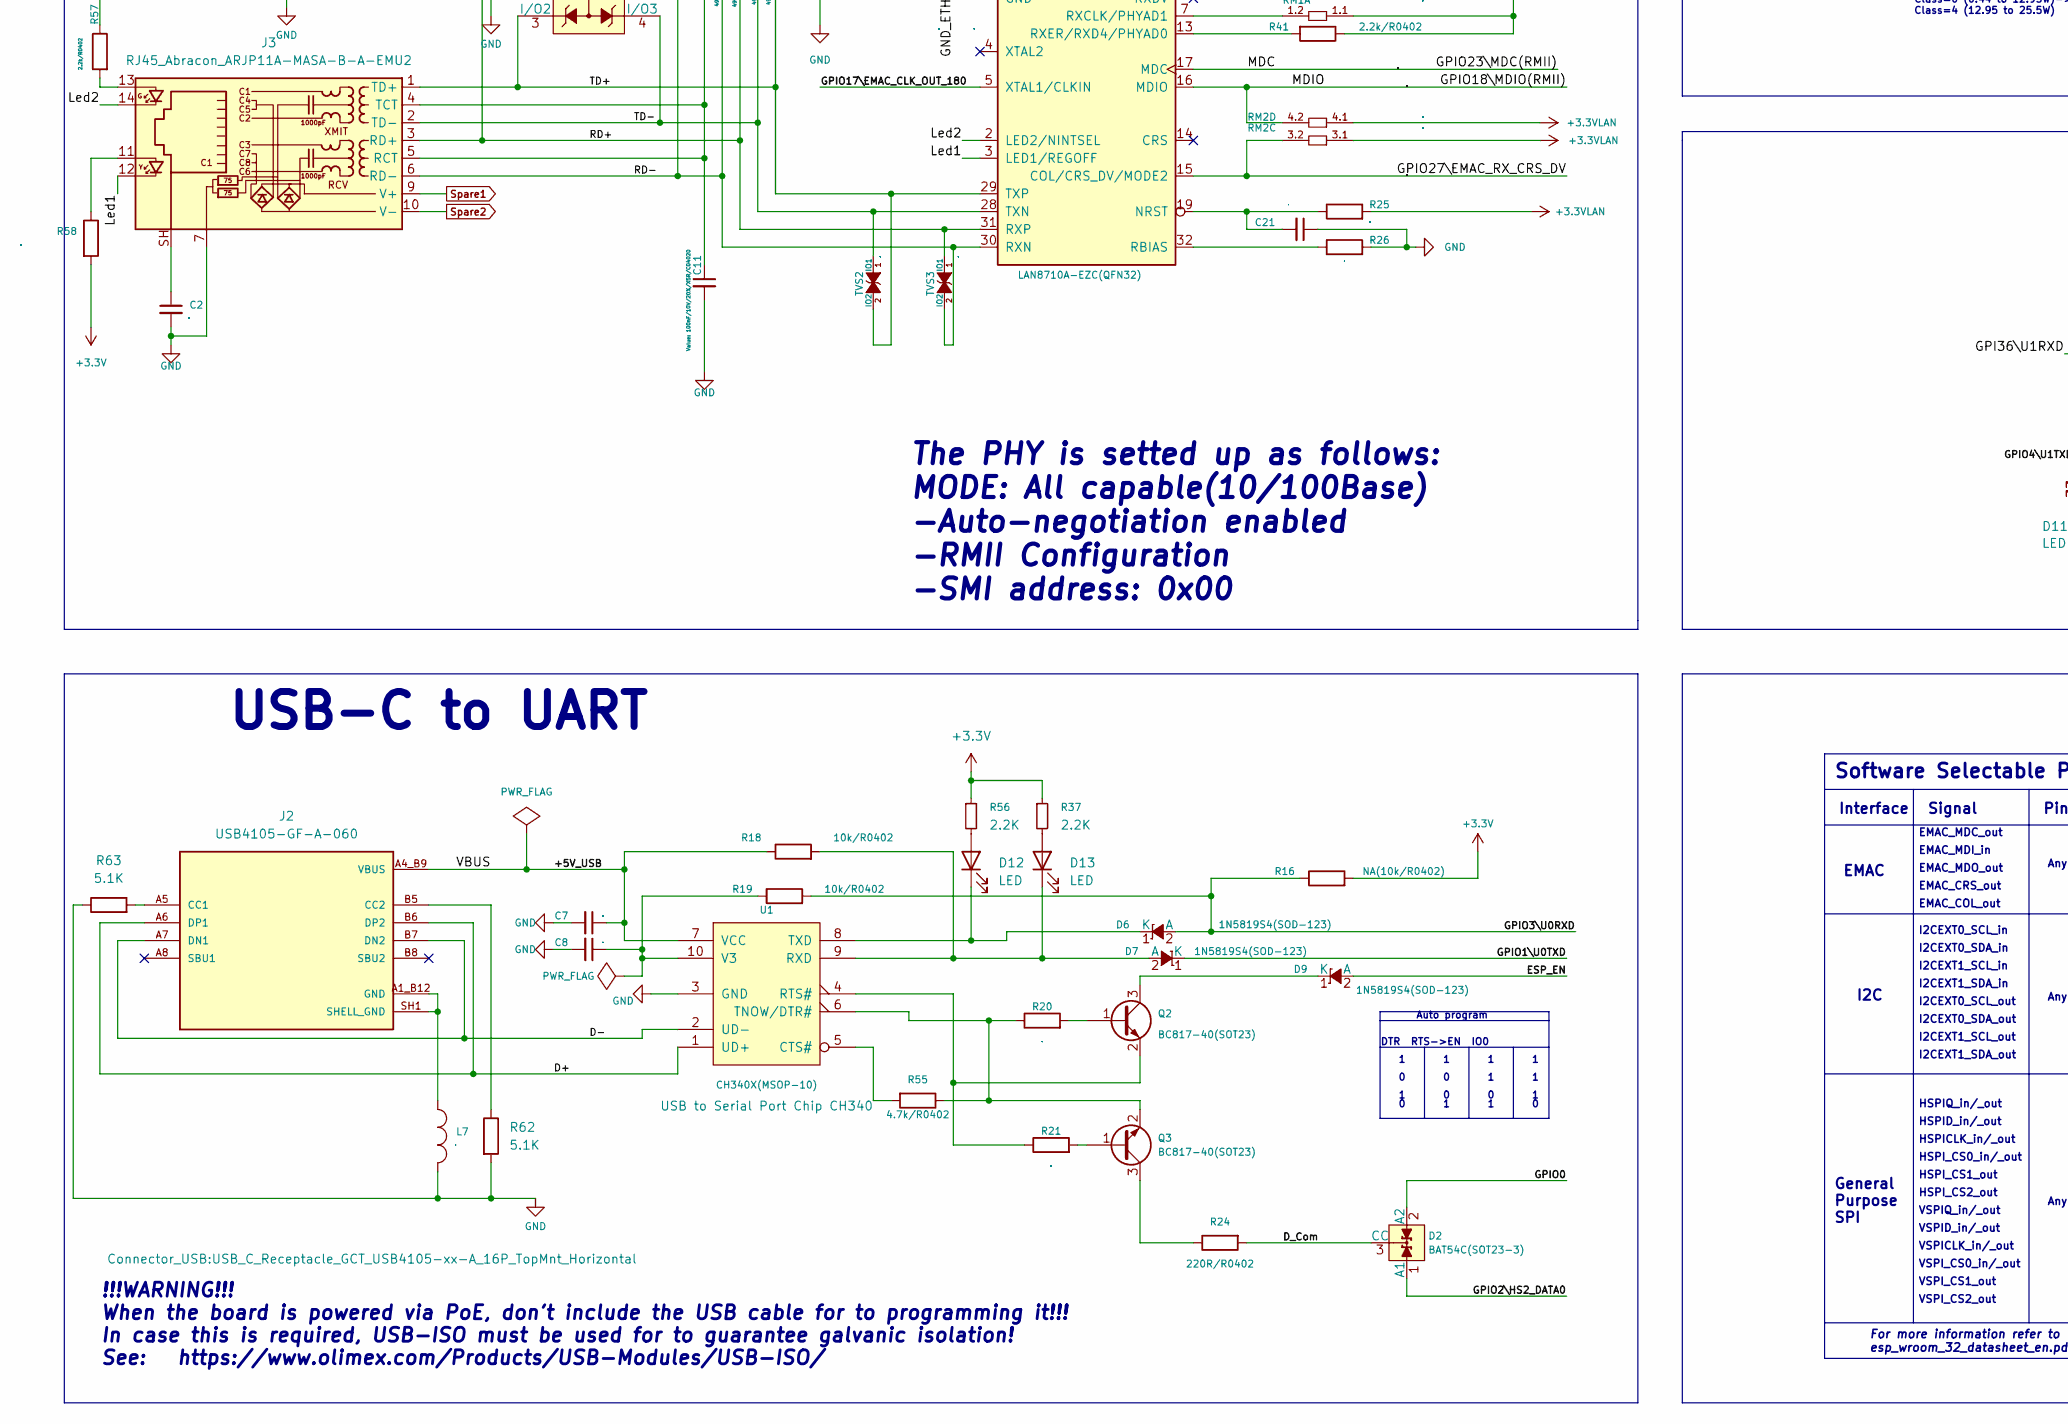
[picture p27: schematic KiBoxLite_H.kicad_sch, ESP32-PoE, part in row 2, column 1]

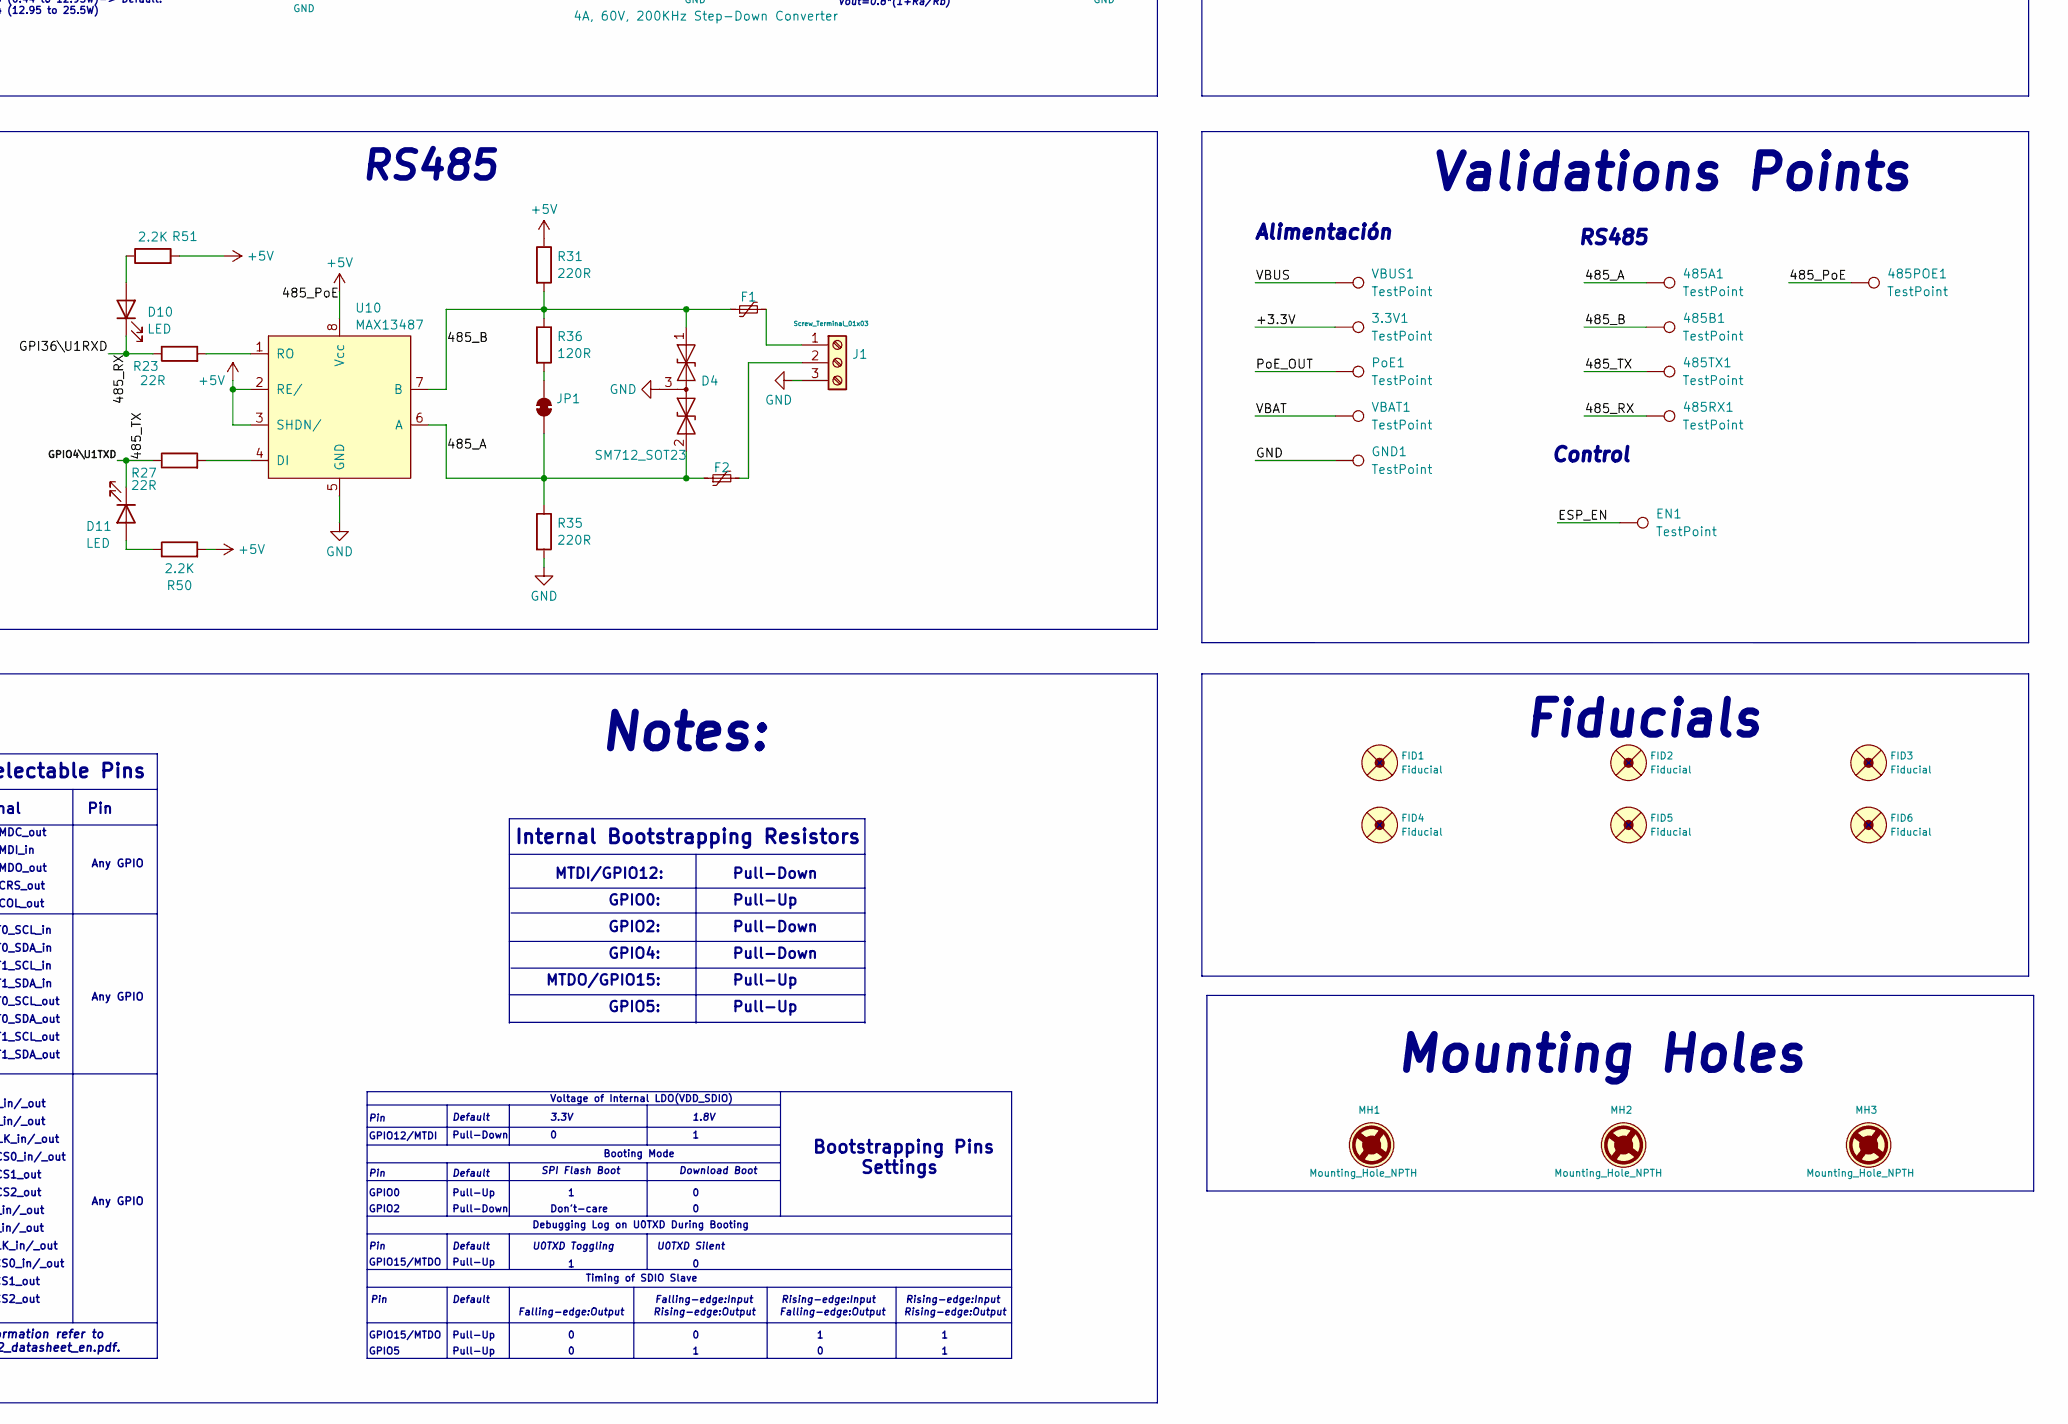
[picture p28: schematic KiBoxLite_H.kicad_sch, ESP32-PoE, part in row 2, column 2]

Parts:
3.3V1, 485A1, 485B1, 485POE1, 485RX1, 485TX1: TestPoint; TestPoint_Pad_1.0x1.0mm
BAT1: DW02S; LIPO_BAT_VERTICAL_DW02S
BAT_SENS_E1: Opened; SJ
BUT1: IT1185AU2; IT1185AU2_V2
C1, C6, C7, C9, C10, C13, C22: 22uF/6.3V/20%/X5R/C0603; C_0603_5MIL_DWS
C2: 1nF/2000V/10%/X7R/C1206; C_1206_5MIL_DWS_ISO
C3: 47uF/6.3V/20%/X5R/C0805; C_0805_5MIL_DWS
C8, C11, C14, C15, C16, C18: 100nF/10V/20%/X5R/C04020; C_0402_5MIL_DWS
C12, C24: 100nF/100V/10%/X7R/C0603; C_0603_5MIL_DWS
C17: 2.2uF/6.3V/10%/X5R/C0603; C_0603_5MIL_DWS
C19: 1nF/50V/10%/X7R/C0402; C_0402_5MIL_DWS
C20: 1uF/10V/20%/X5R/C0603; C_0603_5MIL_DWS
C21: NA(10uF/6.3V/20%/X5R/C0603); C_0603_5MIL_DWS
C23: 12pF/50V/5%/COG/C0402; C_0402_5MIL_DWS
C25: 470uF/10V/20%/Low_ESR/RM2.5/6.0x11mm; CPOL-RM2.5mm_6.3x11mm_PTH
C26: NA(220pF/100V/C0603); C_0603_5MIL_DWS
C27: 15uF/100V/20%/RM2.5/6.3x11mm(Farnell:1281844); CPOL-RM2.5mm_6.3x11mm_PTH
C28: NA(100nF/10V/20%/X5R/C04020); C_0402_5MIL_DWS
C29: NA(120pF/50V/5%/C0G/C0402); C_0402_5MIL_DWS; not fitted
CHRG1: LED/YELLOW/0603; LED_0603_KA
Class4_EN1: Closed; SJ
D1, D3: 1N5822/SS34/SMA; SMA-KA
D2: BAT54C(SOT23-3); SOT23-3
D4: SM712_SOT23; SOT-23
D5: SS510/100V/5A/0.85V/DO214AB(SMC); DO214AB(SMC)_1(K)-2(A)
D6, D7, D9: 1N5819S4(SOD-123); SOD-123_1C-2A_KA
D8: SMAJ58A/SMA; SMA-KA
D10, D11, D12, D13: LED; LED_0201_0603Metric
EN1: TestPoint; TestPoint_Pad_1.0x1.0mm
EXT1, EXT2: NS(HN1x10); HN1x10
F1, F2: Polyfuse_Small; TS250
FET1, FET2, FET3: WPM2015-3/TR; SOT23
FID1, FID2, FID3, FID4, FID5, FID6: Fiducial; Fiducial1x3
GND1: TestPoint; TestPoint_Pad_1.0x1.0mm
J1: Screw_Terminal_01x03; PhoenixContact_MSTBA_2,5_3-G_1x03_P5.00mm_Horizontal
J2: USB4105-GF-A-060; USB_C_Receptacle_GCT_USB4105-xx-A_16P_TopMnt_Horizontal; PARTREV B3
J3: RJ45_Abracon_ARJP11A-MASA-B-A-EMU2; RJ45_Abracon_ARJP11A-MA_Horizontal
JP1: SolderJumper_2_Bridged; SolderJumper_IND_Data
L1, L5, L7: FB0805/600R/2A; L_0805_5MIL_DWS
L2: 1.0uH/4.2A/DCR=35mR/20%/2.00x1.60x1.00mm/L2016(PI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; L_2016_MM
L4: 33uH/2.1A/DCR=0.1R/20%/DBS135(PD3316MT330); DBS135
MH1, MH2, MH3: Mounting_Hole_NPTH; NPTH_2.2mm
MICRO_SD1: TFC-9P-1.7H(ATFFS150A01BR016); uSD(TFC-9P-1.xH(ATFFS150A01BR016))
PWR2: LED/RED/0603; LED_0603_KA
PoE1: TestPoint; TestPoint_Pad_1.0x1.0mm
Q2, Q3: BC817-40(SOT23); SOT23
R1, R2, R6, R18, R19, R25, R32, R39, R48: 10k/R0402; R_0402_5MIL_DWS
R3, R20, R21: 1k/R0402; R_0402_5MIL_DWS
R4: 47k/R0402; R_0402_5MIL_DWS
R5, R8, R41, R57, R58: 2.2k/R0402; R_0402_5MIL_DWS
R7, R42: 9.1k/R2512; R_2512_MM_DWS
R9: 100k/R0402; R_0402_5MIL_DWS
R10, R11, R12, R13: 49.9R/1%/R0402; R_0402_5MIL_DWS
R16: NA(10k/R0402); R_0402_5MIL_DWS
R17, R22: 470k/R0402; R_0402_5MIL_DWS
R23, R27: 22R; R_0402_5MIL_DWS
R24, R46, R47: 220R/R0402; R_0402_5MIL_DWS
R26: 12.1k/1%/R0402; R_0402_5MIL_DWS
R28: 0.03R/1%/R1206; R_1206_5MIL_DWS
R29: 220k/R0402; R_0402_5MIL_DWS
R30: 49.9k/1%/R0402; R_0402_5MIL_DWS
R31, R35: 220R; R_0402_5MIL_DWS
R33: 4.7R/R0402; R_0402_5MIL_DWS
R34: 5.23k/1%/R0402; R_0402_5MIL_DWS
R36: 120R; R_0402_5MIL_DWS
R37, R50, R51, R56: 2.2K; R_0402_5MIL_DWS
R38: 30.1k/1%/R0402; R_0402_5MIL_DWS
R40: 10R/R0402; R_0402_5MIL_DWS
R43: NA(22R/R0603); R_0603_5MIL_DWS
R44, R49: NA/R0402; R_0402_5MIL_DWS
R45: NA(10R/R0402); R_0402_5MIL_DWS
R52: 24.9k/1%/R0402; R_0402_5MIL_DWS
R53: 1.27k/1%/62.5mW/R0402; R_0402_5MIL_DWS
R54: NA(66.5R/1%/125mW/R0805); R_0805_5MIL_DWS
R55: 4.7k/R0402; R_0402_5MIL_DWS
R62, R63: 5.1K; R_0402_5MIL_DWS
RM1, RM2, RM3: RA1206_(4X0603)_4B8_2.2k; R_MATRIX_4
RST1: IT1185AU2; IT1185AU2_V2
T1: LMUN2211LT1G(SOT-23); SOT23
TVS1: ESDS314DBVR(SOT-23-5); SOT-23-5
TVS2, TVS3: NA(GG0402052R542P); D_0402_5MIL_DWS
U1: CH340X(MSOP-10); MSOP-10_Pitch-0.5mm_3.00x3.00x1.00mm
U3: TP4054-42-SOT25-R(SOT23-5); SOT-23-5
U4: LAN8710A-EZC(QFN32); QFN32_EP(33)_5.00x5.00x0.90mm_Pitch_0.50mm
U5: TX4138(ESOIC-8); ESOIC-8
U6: ESP32-WROOM-32E-N4; ESP32-WROVER(WROOM)-UNIVERSAL_MODULE
U7: TPS62A02ADRLR(SOT-563-6); SOT-563-6
U8: NA(SN74LVC1G04DBVR(SOT23-5)); SOT-23-5
U9: TPS2378DDAR(HSOIC-8); ESOIC-8
U10: MAX13487
VBAT1: TestPoint; TestPoint_Pad_1.0x1.0mm
VBUS1: TestPoint; TestPoint_Pad_1.0x1.0mm

Connections:
+3.3V: 3.3V1.1 (1_1), C10.1, C22.1, C29.2, EXT1.2, FET3.2, L2.2, L5.1, R2.1, R16.2, R29.2, R32.1, R37.1, R39.1, R44.2, R48.1, R56.1, R57.1, R58.2, RM3.1.2, RM3.2.2, RM3.3.2, RM3.4.2, U6.2 (VDD33(3V3))
+3.3VLAN: C9.1, C14.1, C28.2, FET3.3, L1.1, R25.2, RM1.3.1, RM2.1.1, RM2.2.1, RM2.3.1, RM2.4.1, U4.12 (VDDIO), U8.5 (VCC)
+5V: 485POE1.1 (1_1), C1.1, CHRG1.2 (A), D1.1 (K), D3.2 (A), EXT2.7, FET1.2, FET2.1, PWR2.2 (A), R1.1, R4.1, R31.1, R50.2, R51.2, U3.4 (VCC), U10.2 (RE/), U10.3 (SHDN/), U10.8 (Vcc)
+5VP: C23.1, C25.1 (+), D1.2 (A), FET1.1, L4.2, R38.1
/485_A: 485A1.1 (1_1), D4.2 (A2), F2.1, JP1.1 (A), R35.1, U10.6 (A)
/485_B: 485B1.1 (1_1), D4.1 (A1), F1.1, R31.2, R36.1, U10.7 (B)
/485_RX: 485RX1.1 (1_1), D10.1 (K), EXT2.2, R23.1, U6.4 (GPI36/SENSOR_VP/ADC1_CH0/RTC_GPIO0)
/485_TX: 485TX1.1 (1_1), D11.1 (K), EXT1.9, R27.1, U6.26 (GPIO4/ADC2_CH0/TOUCH0/RTC_GPIO10/HSPIHD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)
/D+: J2.A6 (DP1), J2.B6 (DP2), U1.1 (UD+)
/D-: J2.A7 (DN1), J2.B7 (DN2), U1.2 (UD-)
/D_Com: D2.3 (CC), R24.2, R49.2
/ESP_EN: C20.1, D9.2 (A), EN1.1 (1_1), EXT1.4, R32.2, RST1.1, U6.3 (EN)
/GPI34\BUT1: BUT1.1, EXT2.4, R48.2, R49.1, U6.6 (GPI34/ADC1_CH6/RTC_GPIO4)
/GPI35: BAT_SENS_E1.1, EXT2.3, U6.7 (GPI35/ADC1_CH7/RTC_GPIO5)
/GPI39: EXT2.1, R4.2, R9.1, U6.5 (GPI39/SENSOR_VN/ADC1_CH3/RTC_GPIO3)
/GPIO0: D2.2 (A2), EXT1.5, R44.1, U6.25 (GPIO0/ADC2_CH1/TOUCH1/RTC_GPIO11/CLK_OU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), U8.2 (A)
/GPIO1\U0TXD: D7.1 (K), EXT1.6, U6.35 (GPIO1/U0TXD/CLK_OUT3/EMAC_RXD2)
/GPIO2\HS2_DATA0: D2.1 (A1), EXT1.7, R46.1, RM3.4.1, U6.24 (GPIO2/ADC2_CH2/TOUCH2/RTC_GPIO12/HSPIWP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)
/GPIO3\U0RXD: D6.2 (A), EXT1.8, R16.1, R19.2, U6.34 (GPIO3/U0RXD/CLK_OUT2)
/GPIO5\SPI_CS: EXT1.10, U6.29 (GPIO5/VSPICS0/HS1_DATA6/EMAC_RX_CLK)
/GPIO12\PHY_PWR: T1.1 (B), U6.14 (GPIO12/ADC2_CH5/TOUCH5/RTC_GPIO15/MTDI/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)
/GPIO13\I2C-SDA: EXT2.10, U6.16 (GPIO13/ADC2_CH4/TOUCH4/RTC_GPIO14/MTCK/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)
/GPIO14\HS2_CLK: EXT2.9, R40.1, U6.13 (GPIO14/ADC2_CH6/TOUCH6/RTC_GPIO16/MTMS/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)
/GPIO15\HS2_CMD: EXT2.8, MICRO_SD1.3 (CMD/DI), R39.2, U6.23 (GPIO15/ADC2_CH3/TOUCH3/MTDO/HSPICS0/RTC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)
/GPIO16\I2C-SCL: EXT1.1, R45.2, U6.27 (NC(GPIO16/HS1_DATA4/U2RXD/EMAC_CLK_OUT))
/GPIO17\EMAC_CLK_OUT_180: U4.5 (XTAL1/CLKIN), U6.28 (NC(GPIO17/HS1_DATA5/U2TXD/EMAC_CLK_OUT_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), U8.4 (Y)
/GPIO18\MDIO(RMII): RM2.4.2, U4.16 (MDIO), U6.30 (GPIO18/VSPICLK/HS1_DATA7)
/GPIO19\EMAC_TXD0(RMII): U4.22 (TXD0), U6.31 (GPIO19/VSPIQ/U0CTS/EMAC_TXD0)
/GPIO21\EMAC_TX_EN(RMII): U4.21 (TXEN), U6.33 (GPIO21/VSPIHD/EMAC_TX_EN)
/GPIO22\EMAC_TXD1(RMII): U4.23 (TXD1), U6.36 (GPIO22/VSPIWP/U0RTS/EMAC_TXD1)
/GPIO23\MDC(RMII): U4.17 (MDC), U6.37 (GPIO23/VSPID/HS1_STROBE)
/GPIO25\EMAC_RXD0(RMII): RM2.2.2, U4.11 (RXD0/MODE0), U6.10 (GPIO25/DAC_1/ADC2_CH8/RTC_GPIO6/EMAC_RX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)
/GPIO26\EMAC_RXD1(RMII): RM2.1.2, U4.10 (RXD1/MODE1), U6.11 (GPIO26/DAC_2/ADC2_CH9/RTC_GPIO7/EMAC_RX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)
/GPIO27\EMAC_RX_CRS_DV: RM2.3.2, U4.15 (COL/CRS_DV/MODE2), U6.12 (GPIO27/ADC2_CH7/TOUCH7/RTC_GPIO17/EMAC_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)
/GPIO32: EXT2.6, U6.8 (GPIO32/XTAL_32K_P/ADC1_CH4/TOUCH9/RTC_G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)
/GPIO33: EXT2.5, R45.1, U6.9 (GPIO33/XTAL_32K_N/ADC1_CH5/TOUCH8/RTC_G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)
/Led1: J3.12, U4.3 (LED1/REGOFF)
/Led2: J3.14, U4.2 (LED2/NINTSEL)
/PoE_OUT: C12.1, D5.1 (K), L4.1, PoE1.1 (1_1), R43.2, U5.1 (SW)
/RD+: J3.3 (RD+), R11.2, TVS1.1 (I/O1), TVS3.1 (IO1), U4.31 (RXP)
/RD-: J3.6 (RD-), R10.2, TVS1.5 (I/O4), TVS3.2 (IO2), U4.30 (RXN)
/TD+: J3.1 (TD+), R13.2, TVS1.3 (I/O2), TVS2.2 (IO2), U4.29 (TXP)
/TD-: J3.2 (TD-), R12.2, TVS1.4 (I/O3), TVS2.1 (IO1), U4.28 (TXN)
/VBAT: BAT1.1, FET2.3, R17.1, U3.3 (VBAT), VBAT1.1 (1_1)
unnamed: BAT_SENS_E1.2, C19.1, R17.2, R22.1
unnamed: BUT1.2, R47.1
unnamed: C2.1, J3.SH
unnamed: C10.2, FET3.1, R2.2, R3.1
unnamed: C12.2, R33.2
unnamed: C26.1, R43.1
unnamed: CHRG1.1 (K), R8.1
unnamed: Class4_EN1.1, R54.2
unnamed: C6.1, D3.1 (K), FET2.2, U7.3 (VIN), U7.4 (EN)
unnamed: D9.1 (K), Q2.3 (C)
unnamed: D10.2 (A), R51.1
unnamed: D11.2 (A), R50.1
unnamed: D12.2 (A), R56.2
unnamed: D6.1 (K), D12.1 (K), U1.8 (TXD)
unnamed: D13.2 (A), R37.2
unnamed: D7.2 (A), D13.1 (K), R18.2, U1.9 (RXD)
unnamed: F1.2, J1.1
unnamed: F2.2, J1.2
unnamed: J2.A5 (CC1), R63.2
unnamed: J2.B5 (CC2), R62.1
unnamed: J3.11, R58.1
unnamed: J3.13, R57.2
unnamed: C11.1, C13.1, C15.1, C16.1, J3.4 (TCT), J3.5 (RCT), L1.2, R10.1, R11.1, R12.1, R13.1, U4.1 (VDD2A), U4.27 (VDD1A)
unnamed: JP1.2 (B), R36.2
unnamed: MICRO_SD1.2 (CD/DAT3/CS), RM3.2.1
unnamed: MICRO_SD1.5 (CLK/SCLK), R40.2
unnamed: MICRO_SD1.7 (DAT0/DO), R46.2
unnamed: MICRO_SD1.8 (DAT1/RES), RM3.1.1
unnamed: MICRO_SD1.1 (DAT2/RES), RM3.3.1
unnamed: C3.1, L5.2, MICRO_SD1.4 (VDD)
unnamed: PWR2.1 (K), R5.1
unnamed: Q2.1 (B), R20.2
unnamed: Q2.2 (E), R21.1, U1.4 (RTS#)
unnamed: Q3.1 (B), R21.2
unnamed: Q3.3 (C), R24.1
unnamed: Q3.2 (E), R20.1, R55.1, U1.6 (TNOW/DTR#)
unnamed: R28.1, U5.2 (ILIM), U5.9 (ILIM)
unnamed: R3.2, T1.3 (C)
unnamed: R55.2, U1.5 (CTS#)
unnamed: C8.1, R19.1, U1.10 (V3)
unnamed: R8.2, U3.1 (CHRGb)
unnamed: R6.1, U3.5 (PROG)
unnamed: C21.2, R25.1, U4.19 (NRST)
unnamed: R26.1, U4.32 (RBIAS)
unnamed: RM1.1.2, U4.7 (RXCLK/PHYAD1)
unnamed: RM1.3.2, U4.9 (RXD2/RMIISEL)
unnamed: RM1.2.2, U4.8 (RXD3/PHYAD2)
unnamed: R41.2, U4.13 (RXER/RXD4/PHYAD0)
unnamed: C17.1, C18.1, U4.6 (VDDCR)
unnamed: R33.1, U5.8 (BS)
unnamed: U5.6 (EN), U9.6 (CDB)
unnamed: C23.2, R34.1, R38.2, U5.5 (FB)
unnamed: C29.1, R29.1, R30.1, U7.5 (FB)
unnamed: L2.1, U7.2 (SW)
unnamed: Class4_EN1.2, R53.1, U9.3 (CLS)
unnamed: R52.2, U9.2 (DEN)
unnamed: R27.2, U10.4 (DI)
unnamed: R23.2, U10.1 (RO)
Spare1: C24.1, C27.1 (+), D8.1 (K), J3.9 (V+), R7.1, R28.2, R42.1, R52.1, U5.3 (Vin), U9.1 (VDD)
Spare2: C24.2, D8.2 (A), J3.10 (V-), R53.2, R54.1, U9.4 (VSS), U9.9 (EPAD)
VBUS: C7.1, FET1.3, J2.A4_B9 (VBUS), J2.B4_A9 (VBUS), R18.1, U1.7 (VCC), VBUS1.1 (1_1)

Notes on the sheet:
HSPI_CS1_out
Pull-Down
EMAC_MDO_out
HSPI_CS2_out
GPIO4:
Falling-edge:Output
Control
EMAC
I2CEXT0_SDA_out
Default
MTDO/GPIO15:
For more information refer to esp_wroom_32_datasheet_en.pdf.
Rprog
VSPICLK_in/_out
PoE Power Supply
Fiducials
HSPIQ_in/_out
Interface
DTR RTS->EN IO0
Pull-Up
CHARGING
Any GPIO
The PHY is setted up as follows: MODE: All capable(10/100Base) -Auto-negotiation enabled -RMII Configuration -SMI address: 0x00
LiPo Charger
VSPI_CS2_out
VSPI_CS0_in/_out
HSPID_in/_out
VSPID_in/_out
Pin
VSPIQ_in/_out
I2CEXT1_SDA_in
Buttons
I2CEXT0_SCL_out
MTDI/GPIO12:
I2CEXT1_SCL_in
GPIO5
SPI Flash Boot
Vout=0.6*(1+Ra/Rb)
RDET
HSPI_CS0_in/_out
Notes:
Extensions
Notes related to TP4054-42-SOT25-R: 1. It's recommended VCC range is: (4.0~9.0)V 2. For the Programming Charge Current I(Bat) there are two equations: When I(Bat)≤0.15A, then: I(Bat) = 1000/Rprog = 100mA When I(Bat)>0.15A, then: Rprog = 1000/I(Bat)*(1.2-4/3*I(Bat))
Rclass
Auto program
I2CEXT0_SCL_in
Class=0 (0.44 to 12.95W)-> Default! Class=4 (12.95 to 25.5W)
RS485
CDET
I2CEXT1_SCL_out
GPIO0:
!!!WARNING!!! When the board is powered via PoE, don't include the USB cable for to programming it!!! In case this is required, USB-ISO must be used for to guarantee galvanic isolation! See: https://www.olimex.com/Products/USB-Modules/USB-ISO/
EMAC_CRS_out
Rising-edge:Output
GPIO15/MTDO
Rising-edge:Input
External Power Sense
Internal Bootstrapping Resistors
or ESP32-WROVER-E
ESP32 MODULE
HSPICLK_in/_out
Voltage of Internal LDO(VDD_SDIO)
Software Selectable Pins
5V/2A
SD/MMC Card
GPIO0
Debugging Log on U0TXD During Booting
Validations Points
EMAC_MDI_in
EMAC_COL_out
In RMII Mode
Alimentación
USB-C to UART
Power Supply
3.3V
I2C
Mounting Holes
GPIO2
General Purpose SPI
1.8V
GPIO2:
Don't-care
Vout=0.8*(1+Ra/Rb)
GPIO5:
EMAC_MDC_out
Battery Measurement
GPIO12/MTDI
I2CEXT0_SDA_in
Timing of SDIO Slave
Ethernet
Bootstrapping Pins Settings
Falling-edge:Input
Booting Mode
U0TXD Silent
U8, C28 and R45 have to be Populated -> when WROVER is used, U8, C28 and R45 have to be NA -> when WROOM is used.
VSPI_CS1_out
Download Boot
Signal
I2CEXT1_SDA_out
U0TXD Toggling

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
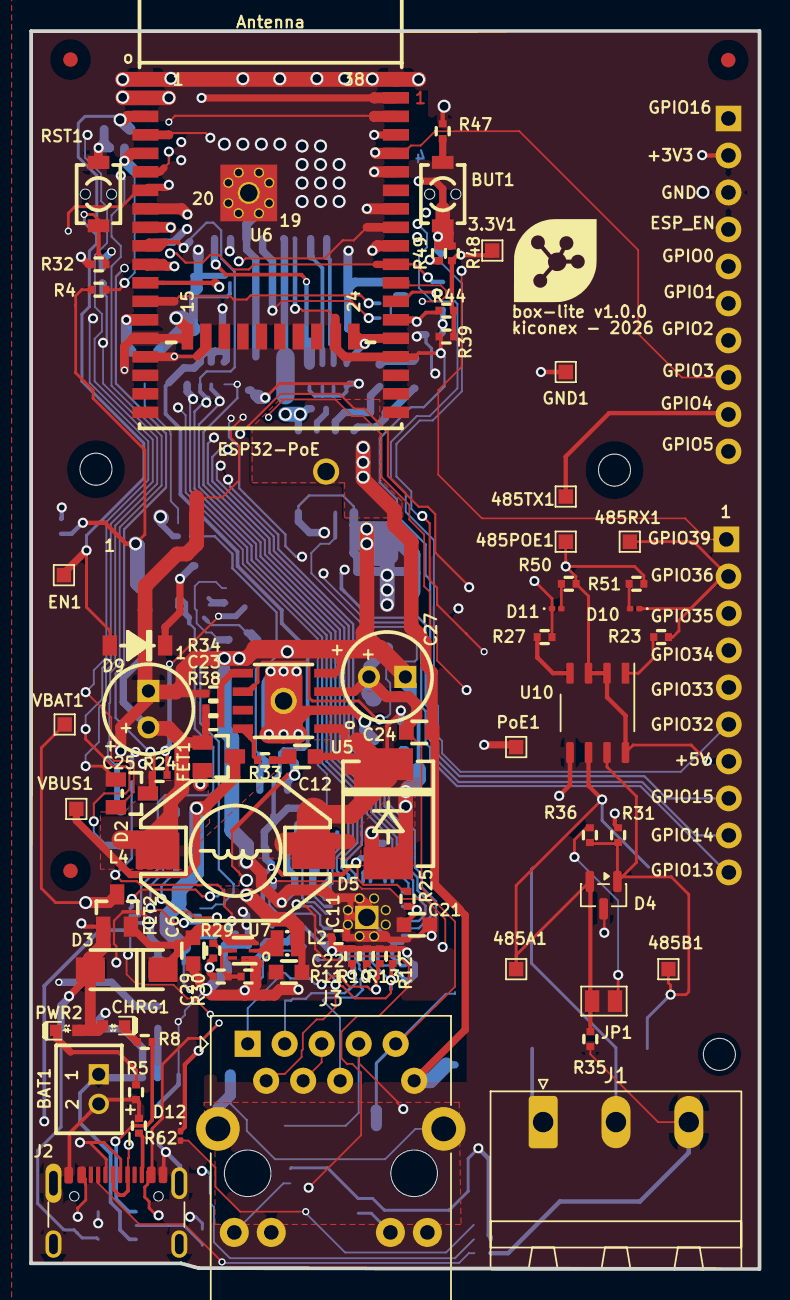
[picture p29: board KiBoxLite_H.kicad_pcb from above]

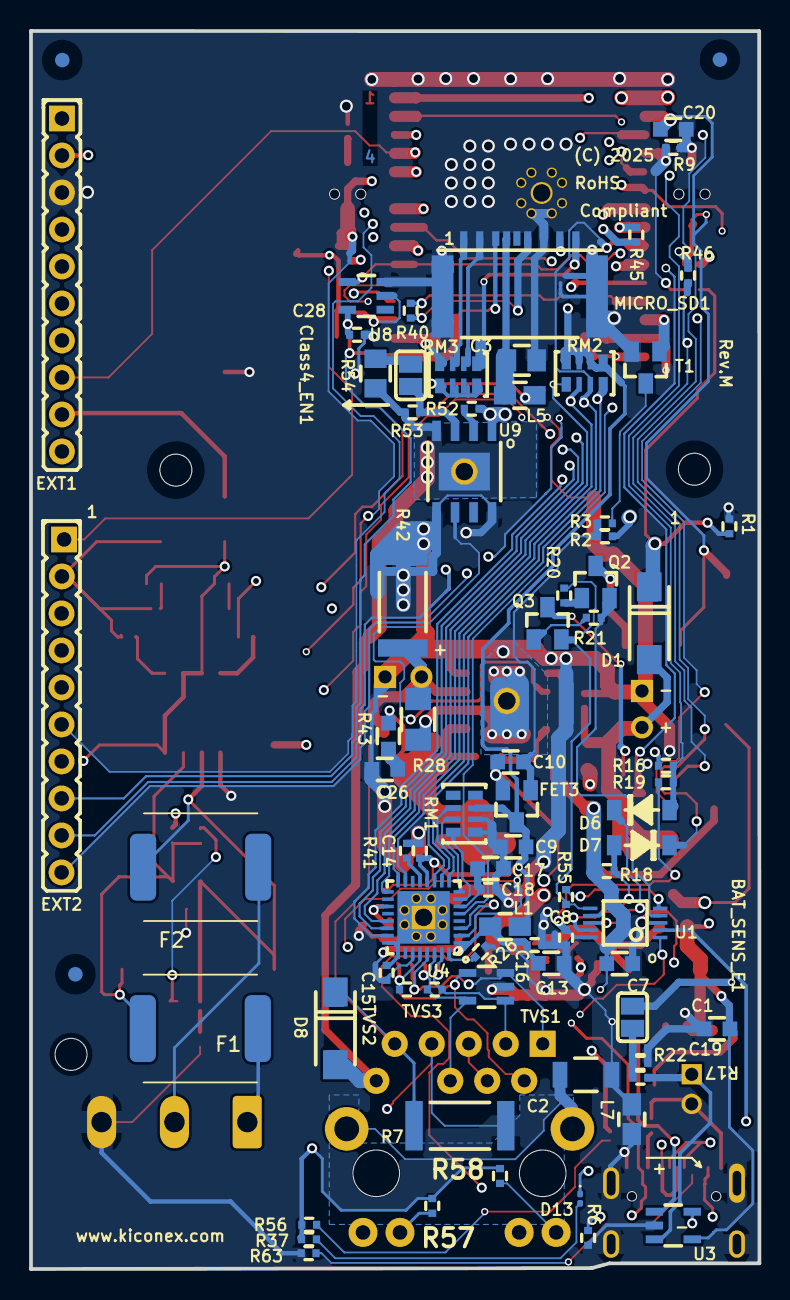
[picture p30: board KiBoxLite_H.kicad_pcb from below]

Board: 4 copper layers, 50.0 x 85.0 mm, 161 parts (80 on the bottom side), 106 nets.

Other parts of the board:
Logo: logo_ki_10x10mm
