Samael312/ESPKI/(commit log)

2026-03-27 Initial commit: KiBoxLite project modules
    [1-281740-2.stp, 1.25T-2AWTP(MOLEX_53261-0271).step, 10118194.step, 1871916-1.stp, 20-pin_SMT_header.STEP, 20PinMaleSmt.stp, 29658.stp, 40PinMaleSMD.stp]
2026-03-27 Limpieza: aplicando .gitignore a archivos existentes
    [ESP32-PoE_Rev_B-B.Cu.gbr, ESP32-PoE_Rev_B-B.Mask.gbr, ESP32-PoE_Rev_B-B.Paste.gbr, ESP32-PoE_Rev_B-B.SilkS.gbr, ESP32-PoE_Rev_B-Edge.Cuts.gbr, ESP32-PoE_Rev_B-F.Cu.gbr, ESP32-PoE_Rev_B-F.Mask.gbr, ESP32-PoE_Rev_B-F.Paste.gbr]
2026-04-06 build: USB-C Connected
    [KiBoxLite_H.kicad_sch]
2026-04-10 build: 0 errores 2
    [KiBoxLite_H.kicad_pcb]
2026-04-13 build: Estructura organizada
    [1-281740-2.stp, 10118194.step, 1871916-1.stp, 20-pin_SMT_header.STEP, 629105150521.stp, 687112183722.stp, 687120183722.stp, 693063020911.stp]
2026-04-13 build: TestPoint logo
    [KiBoxLite_H.kicad_sch]
2026-04-15 build: .step
    [Box-Lite.FCStd, KiBoxLite_H.kicad_sch]
2026-04-15 build: carcasa iniciada
    [Box-Lite.FCStd, Carcasa.FCStd, Ensamblaje.FCStd]
2026-04-20 build: fuse ts250
    [Carcasa.FCStd, KiBoxLite_H.kicad_pcb, KiBoxLite_H.kicad_sch]
2026-04-20 build: fuse ts250 modelo 3d
    [KiBoxLite_H.kicad_pcb]
2026-04-23 build: Cambio de puerto rs485
    [Box-Lite.FCStd, Carcasa.FCStd, Ensamblaje.FCStd, KiBoxLite_H.kicad_pcb, KiBoxLite_H.kicad_sch]
2026-04-24 build: Documentacion Hardware
    [Base.step, Cubierta.step]
2026-04-24 Actualizado gitignore y dejada de rastrear carpeta build
2026-04-27 build: rj45 con leds
    [KiBoxLite_H.kicad_pcb, KiBoxLite_H.kicad_sch]
2026-05-05 build: optimizacion pcb
    [KiBoxLite_H.kicad_pcb, KiBoxLite_H.kicad_sch]
2026-05-05 build: gerbers pcb
    [KiBoxLite_H.kicad_pcb]
2026-05-05 build: Lista y gerber
    [KiBoxLite_H-B_Cu.gbr, KiBoxLite_H-B_Mask.gbr, KiBoxLite_H-B_Paste.gbr, KiBoxLite_H-B_Silkscreen.gbr, KiBoxLite_H-Edge_Cuts.gbr, KiBoxLite_H-F_Cu.gbr, KiBoxLite_H-F_Mask.gbr, KiBoxLite_H-F_Paste.gbr]
2026-05-06 build: Fabricacion
    [KiBoxLite_H-B_Cu.gbr, KiBoxLite_H-B_Mask.gbr, KiBoxLite_H-B_Paste.gbr, KiBoxLite_H-B_Silkscreen.gbr, KiBoxLite_H-Edge_Cuts.gbr, KiBoxLite_H-F_Cu.gbr, KiBoxLite_H-F_Mask.gbr, KiBoxLite_H-F_Paste.gbr]
2026-05-07 build: gerbers pcb ACT
    [KiBoxLite_H_BOM.csv, partitions.csv]
2026-05-21 build: timer sampling modbus optimizado
    [partitions.csv]
2026-05-28 build: cache de pulling modbus
2026-06-04 fix: depuracion dead code
    [kx_config.h, kx_modbus_master.c, kx_modbus_master.h, main.c]
2026-06-04 fix: optimizacion de queud
    [kx_modbus_master.c]
2026-06-05 fact: modularizacion parcial con error
    [kx_modbus_master.c, kx_modbus_uart.c, kx_modbus_uart.h]
2026-06-11 refact: error de desbordamiento
    [kx_modbus_master.c, kx_modbus_master.h, main.c]
2026-06-15 fix: tcp error reports
    [kx_modbus_dispatch.c, kx_modbus_pipeline.c, kx_modbus_report.c]
