Samael312/ESPKI/(notices)

Notices in the files:
Hardware/KiBoxLite_H.kicad_pcb:
(C) 2025
